SiDaMan1/Greenpower-Telemetry-REPO/esc controller/pcb/drc_report.txt

** Drc report for esc-controller.kicad_pcb **
** Created on 2026-09-05 22:09:33 **

** Found 0 DRC violations **

** Found 0 unconnected pads **

** Found 0 Footprint errors **

** End of Report **
