SiDaMan1/Greenpower-Telemetry-REPO/SESSION_NOTES.md

# SESSION_NOTES.md

**This file summarizes the most recent Claude Code session on this repo** — what got done, why, and anything still open. It's a companion to the `CLAUDE.md` files, not a replacement: `CLAUDE.md` files hold durable, load-bearing facts about the code; this file holds the narrative — what was discussed, decided, and why, that might not otherwise survive into a fresh session. It is **overwritten by each session**, not appended to — read it once at the start of a new session, then let it get replaced when that session wraps up.

---

## Session: 2026-08-20 (mobile PWA overhaul, agent tray icon, repo hand-off setup)

### What this session did, roughly in order

1. **Mobile UI added to `telemetry_web`** — the dashboard was desktop-only before this; added a real mobile layout (same `index.html`, CSS-gated) with PWA installability (manifest, service worker, icons).
2. **Several iterations on the mobile nav**, ending at: a fixed (non-scrollable) bottom bar showing 5 primary tabs (Overview/Speed/Power/RPM/ESC) as icon-only square buttons, plus an "expand" button that opens a small sheet listing all 12 tabs with icon+label. The expand button morphs its icon (hamburger↔X) rather than just rotating it — a plain rotation of a symmetric hamburger icon reads as "no animation happened."
3. **Overview page on mobile**: numbers-only (graphs hidden), stat cards are perfect squares in a 2-column grid with equal gaps on every side.
4. **Icon system**: replaced all emoji UI icons (nav, buttons, header) with a hand-authored inline-SVG set (`ICONS` map in `index.html`, applied via `applyIcons()`). Also replaced the placeholder lightning-bolt SVG app icon with the real Greenpower badge logo (PNG, generated at multiple sizes: favicon, apple-touch-icon, PWA icons incl. maskable) — used for the browser tab, home-screen icon, and the install prompt's own icon.
5. **Install prompt** is a small floating button + popover, not a banner — mobile-only (explicitly hidden on desktop via `@media (min-width:861px)` after it showed up there once).
6. **Raceline tab** now shows a real satellite map (Leaflet + Esri World Imagery tiles) with the GPS trail drawn on top, replacing a from-scratch canvas drawing that had no actual imagery.
7. **Chart stability fixes**: charts used to visibly lurch as the first few real data points arrived (auto-fitting axes to almost nothing). Now pre-filled with `MAX_POINTS` null placeholders + per-metric y-axis `suggestedMin/Max` seeded from `METRICS[k].range`. Chart tooltips now work on both hover (desktop) and tap (mobile) — they silently never worked before (`intersect:true` default against 0-radius points, which could never be hit).
8. **Real bugs found and fixed** (not design choices): IMU page's two chart-row sections overlapped on mobile (a `flex:1;min-height:0` sizing bug — the only page with two such stacked sections, so it was the only page where it showed); "LIVE" rendered twice in the header (duplicate write to `age-badge`); the mobile nav "expand" sheet was fully non-functional despite passing every event-wiring check (`.show` never set `display:`, only opacity/transform — classList/click-based testing can't catch a `display:none` bug since programmatic `.click()` doesn't require visibility); the bottom nav's active-tab highlight was a 44×42px box instead of a perfect square (hardcoded `width:44px` didn't match the margin-derived height) — switched to `aspect-ratio:1/1`.
9. **`receiver_agent` got a system tray icon** (`systray` npm package — note: `node-systray`/`node-systray-v2` are NOT what's published to npm despite what a lot of docs/READMEs imply; the real package name is `systray`). Shows a Greenpower-icon in the Windows tray whenever the agent is running, with a right-click "Stop Agent" menu item. **Not yet exercised on a live restart** — the agent needs to be restarted (re-run `setup.bat`, or next login) to pick this up, since Node doesn't hot-reload.
10. **`receiver_agent/config.json`** (real API key + dashboard URL) is now committed to git, previously gitignored — **the user was explicitly warned this repo is public** and confirmed they wanted to proceed anyway. If that key is ever rotated, it needs updating in Railway *and* in this committed file.
11. **Root-level docs added**: `README.md` (human-facing, includes a one-click "Download Receiver Agent" zip button via download-directory.github.io) and `CLAUDE.md` (AI-facing project map, this file's sibling).

### Known open items / things to double check next session
- The tray icon has not been confirmed working on an actual restarted agent process — worth asking if it looks right after the user restarts it.
- The Android PWA installed-app status bar showing the wrong (blue, not matching background) color was diagnosed as Chrome caching the *old* manifest on an already-installed copy — the fix is uninstall+reinstall the PWA on the phone, not a code change. Worth confirming this actually resolved it after the user does that.
- A lot of this session's CSS-transition/animation work was verified *structurally* (computed styles, classes) rather than visually, because the browser-preview tool used for verification in this environment doesn't composite frames (and so can't animate) unless its pane is actively displayed — this is a tooling limitation, documented in `telemetry_web/CLAUDE.md`, not a real limitation of the shipped code. If an animation ever looks broken to a real user, don't assume the earlier verification was wrong just because it couldn't watch the animation play.

### Why this file exists
The user asked, after a long back-and-forth about remote sessions and cloud hand-off: "can anyone make a new claude code session and pick up directly where i left off with no difference." The honest answer was: the code + `CLAUDE.md` files transfer perfectly, but *this specific conversation's history* — the discussion, the reasoning, the "why" that never made it into a committed file — does not. This file is the mitigation: a per-session summary of exactly that, committed alongside the code.
