SiDaMan1/Greenpower-Telemetry-REPO/esc controller/Claude outputs/bot.png

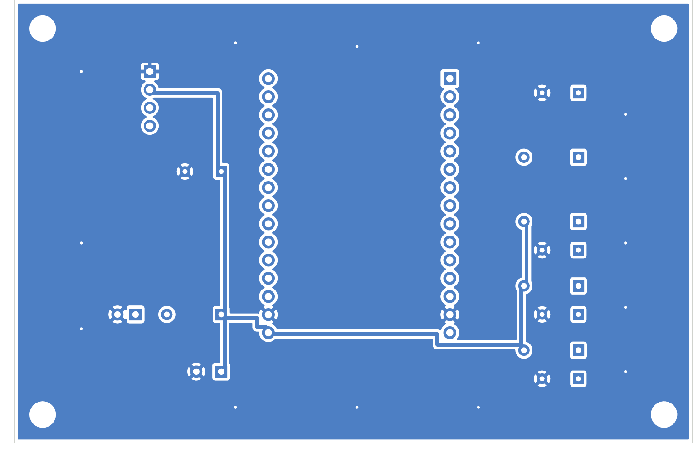
esc controller/Claude outputs/bot.png
