SiDaMan1/Greenpower-Telemetry-REPO/esc controller/Claude outputs/top.png

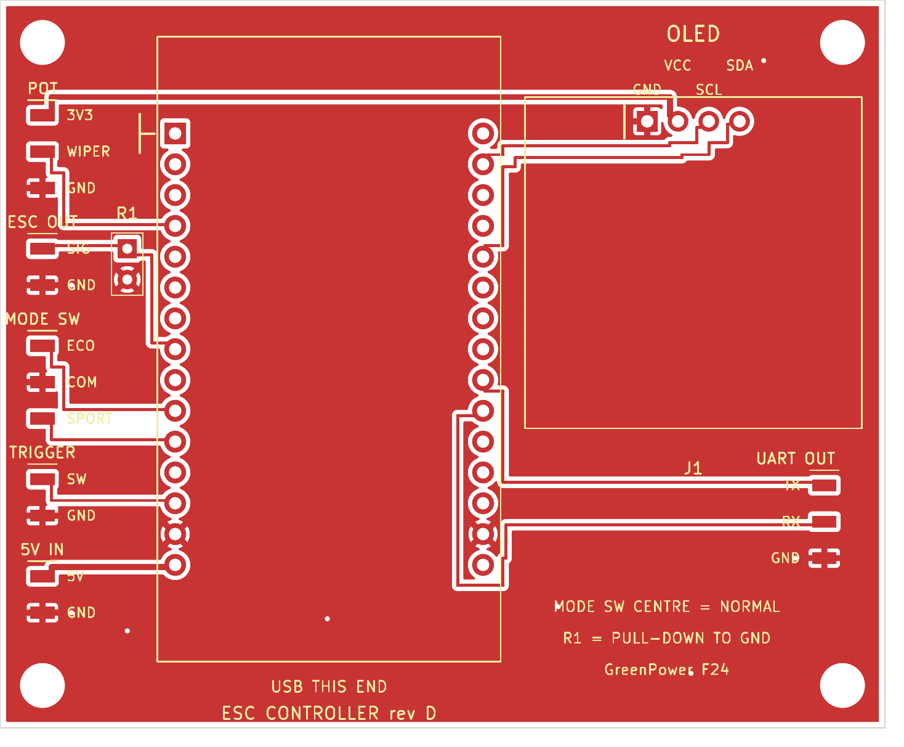
esc controller/Claude outputs/top.png
