SiDaMan1/Greenpower-Telemetry-REPO/esc controller/pcb/preview/bot.png

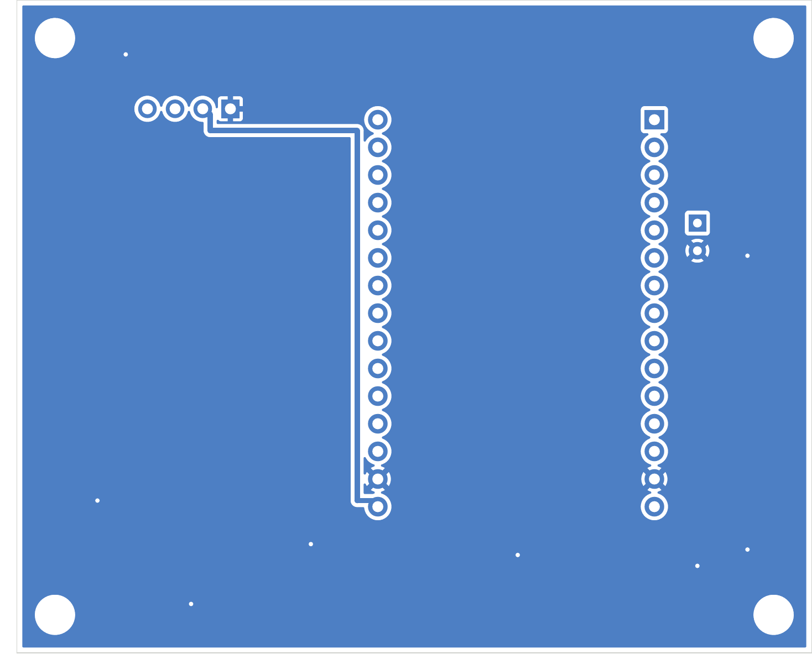
esc controller/pcb/preview/bot.png
