SiDaMan1/Greenpower-Telemetry-REPO/esc controller/pcb/preview/sch.png

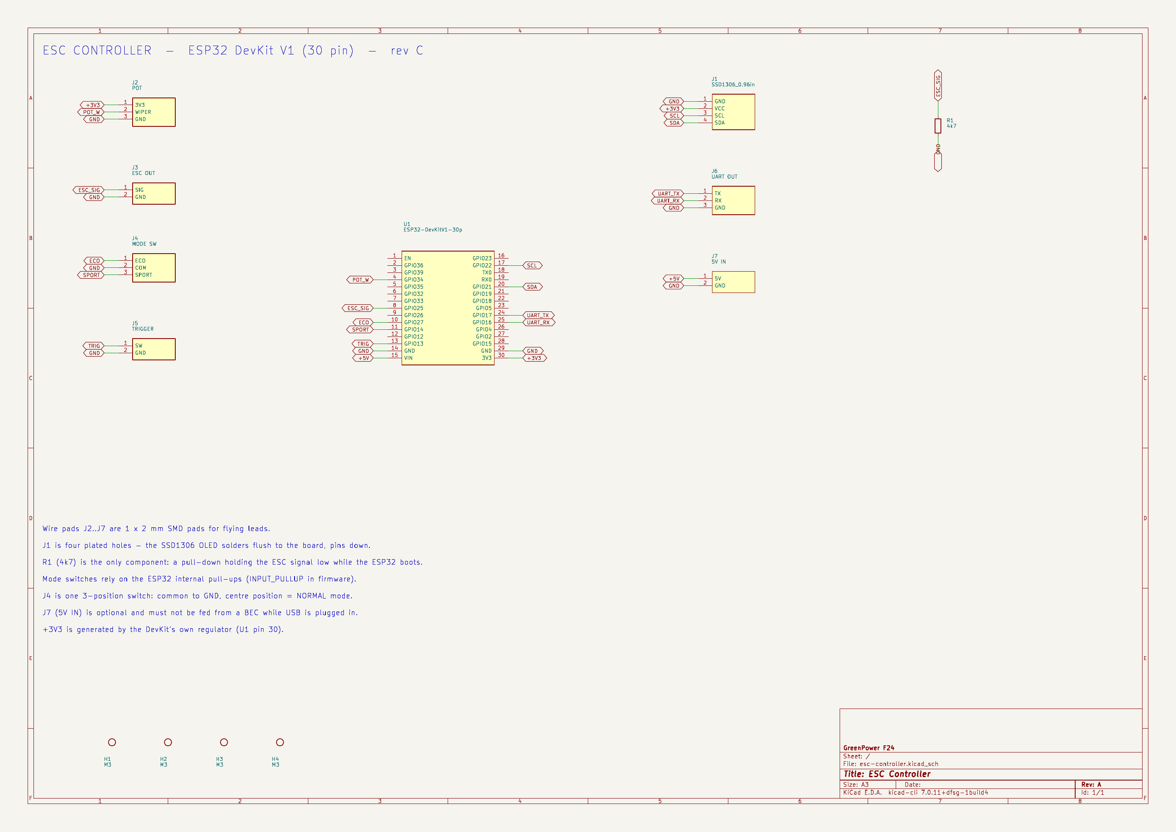
esc controller/pcb/preview/sch.png
