SiDaMan1/Greenpower-Telemetry-REPO/esc controller/pcb/esc-controller.kicad_pcb

## KiCad design esc controller/pcb/esc-controller.kicad_pcb (2026-09-10)

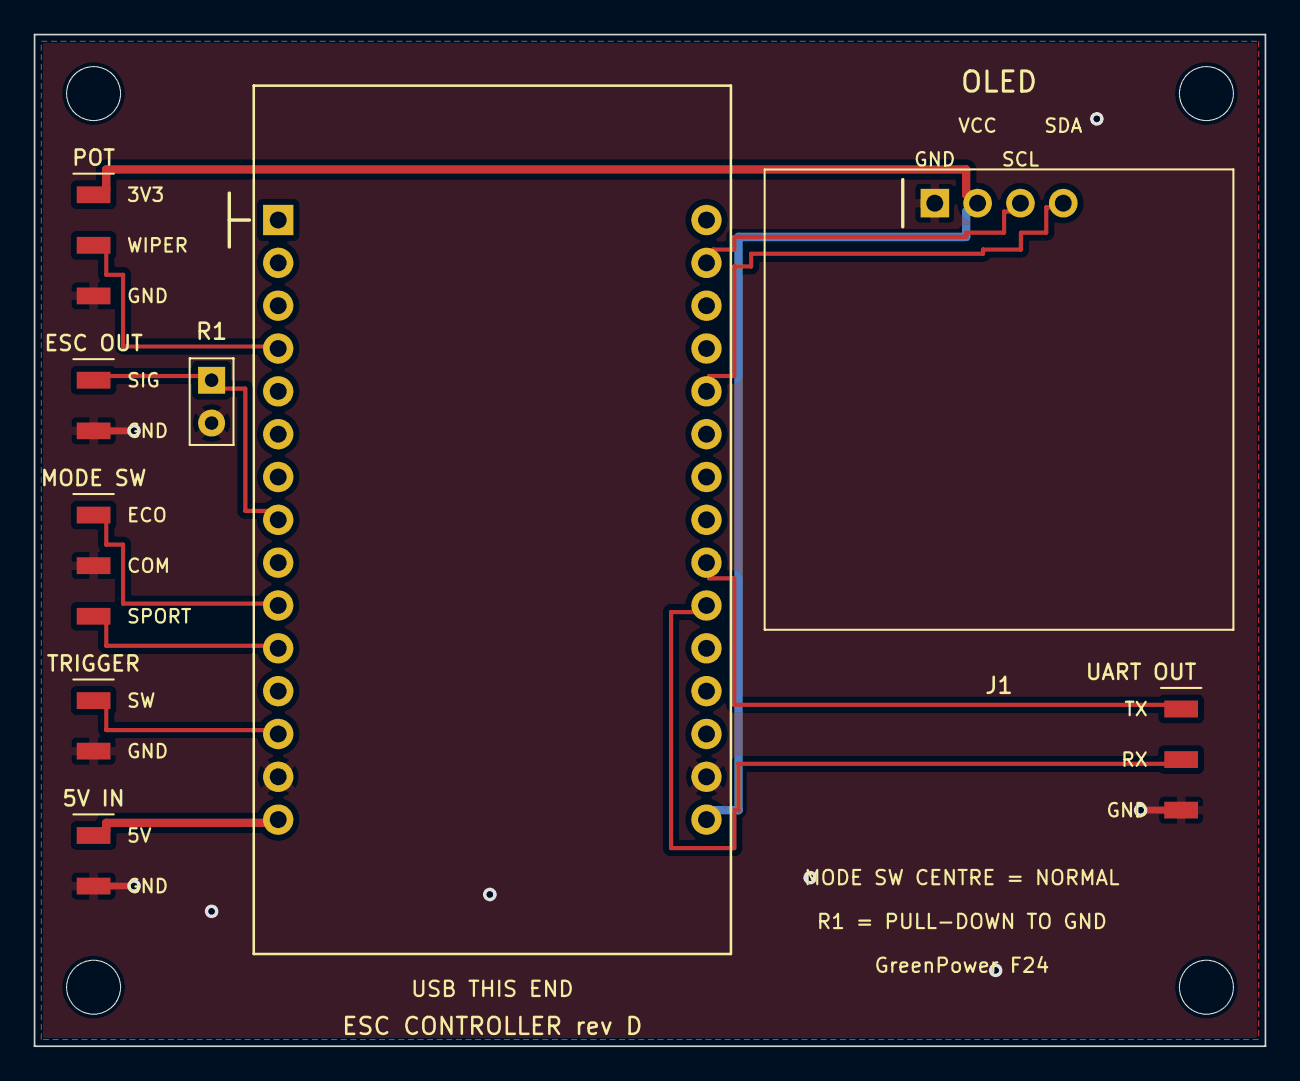
[picture p5: board esc-controller.kicad_pcb from above]

Board: 2 copper layers, 73.0 x 60.0 mm, 13 parts (0 on the bottom side), 12 nets.

Parts:
H1, H2, H3, H4: MountingHole_M3; MountingHole_3.2mm_M3
J1: SSD1306_0.96in; OLED_SSD1306_096_FLUSH_1x4
J2: WirePads; SOLDERPAD_POT_3P
J3: WirePads; SOLDERPAD_ESC_OUT_2P
J4: WirePads; SOLDERPAD_MODE_SW_3P
J5: WirePads; SOLDERPAD_TRIGGER_2P
J6: WirePads; SOLDERPAD_UART_OUT_3P
J7: WirePads; SOLDERPAD_5V_IN_2P
R1: 4k7; Resistor_THT_Axial_P2.54mm_Vertical
U1: ESP32-DevKitV1-30p; ESP32_DEVKITV1_30P_SOCKET

Connections:
+3V3: J1.2, J2.1, U1.30
+5V: J7.1, U1.15
ECO: J4.1, U1.10
ESC_SIG: J3.1, R1.1, U1.8
GND: J1.1, J2.3, J3.2, J4.2, J5.2, J6.3, J7.2, R1.2, U1.14, U1.29
POT_W: J2.2, U1.4
SCL: J1.3, U1.17
SDA: J1.4, U1.20
SPORT: J4.3, U1.11
TRIG: J5.1, U1.13
UART_RX: J6.2, U1.25
UART_TX: J6.1, U1.24
