SiDaMan1/Greenpower-Telemetry-REPO/Telemetry_pcb/Data collection pcb/Data collection pcb.kicad_pcb

## KiCad design Telemetry_pcb/Data collection pcb/Data collection pcb.kicad_pcb (2026-09-09)

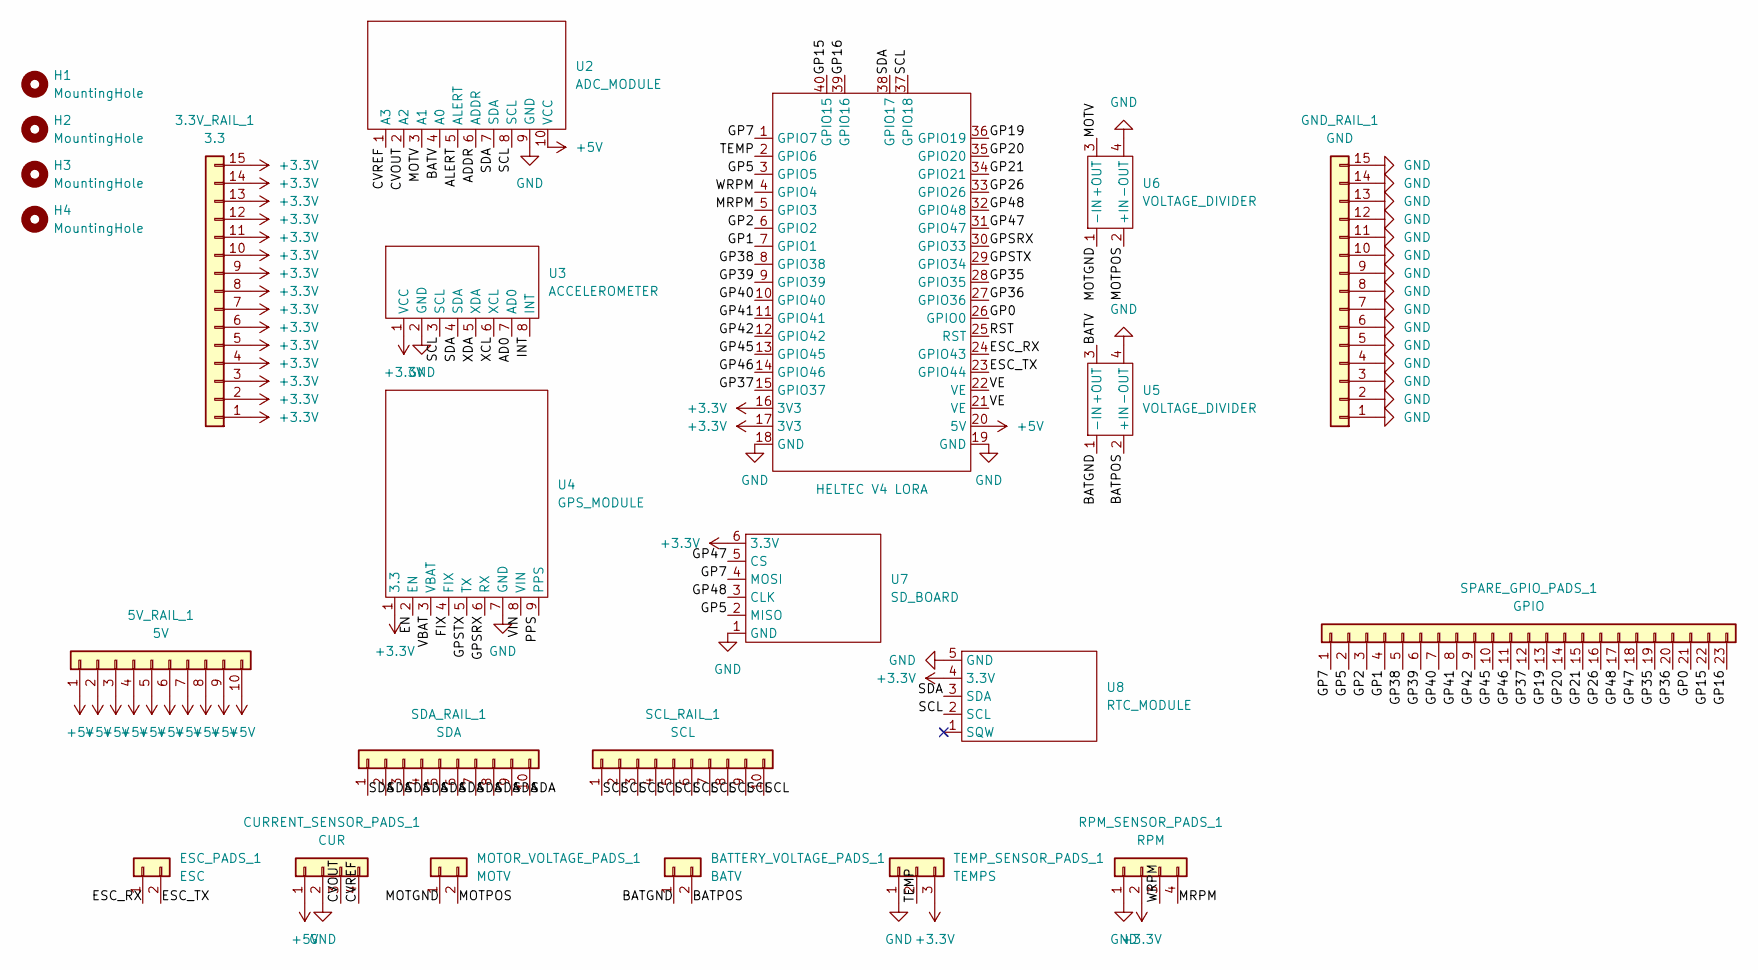
[picture p6: schematic Data collection pcb.kicad_sch]

Parts:
3.3V_RAIL_1: 3.3; 1X15 PADS
5V_RAIL_1: 5V; 1X10 PADS
BATTERY_VOLTAGE_PADS_1: BATV; 1X02 PADS
CURRENT_SENSOR_PADS_1: CUR; 1X04 PADS
ESC_PADS_1: ESC; 1X02 PADS
GND_RAIL_1: GND; 1X15 PADS
H1, H2, H3, H4: MountingHole; MountingHole_3.2mm_M3
MOTOR_VOLTAGE_PADS_1: MOTV; 1X02 PADS
RPM_SENSOR_PADS_1: RPM; 1X04 PADS
SCL_RAIL_1: SCL; 1X10 PADS
SDA_RAIL_1: SDA; 1X10 PADS
SPARE_GPIO_PADS_1: GPIO; 1X23 PADS
TEMP_SENSOR_PADS_1: TEMPS; 1X03 PADS
U1: HELTEC V4 LORA; HELTEC V4
U2: ADC_MODULE
U3: ACCELEROMETER
U4: GPS_MODULE
U5, U6: VOLTAGE_DIVIDER
U7: SD_BOARD
U8: RTC_MODULE

Connections:
+3.3V: 3.3V_RAIL_1.1, 3.3V_RAIL_1.2, 3.3V_RAIL_1.3, 3.3V_RAIL_1.4, 3.3V_RAIL_1.5, 3.3V_RAIL_1.6, 3.3V_RAIL_1.7, 3.3V_RAIL_1.8, 3.3V_RAIL_1.9, 3.3V_RAIL_1.10, 3.3V_RAIL_1.11, 3.3V_RAIL_1.12, 3.3V_RAIL_1.13, 3.3V_RAIL_1.14, 3.3V_RAIL_1.15, RPM_SENSOR_PADS_1.2, TEMP_SENSOR_PADS_1.3, U1.16 (3V3), U1.17 (3V3), U3.1 (VCC), U4.1 (3.3), U7.6 (3.3V), U8.4 (3.3V)
+5V: 5V_RAIL_1.1, 5V_RAIL_1.2, 5V_RAIL_1.3, 5V_RAIL_1.4, 5V_RAIL_1.5, 5V_RAIL_1.6, 5V_RAIL_1.7, 5V_RAIL_1.8, 5V_RAIL_1.9, 5V_RAIL_1.10, CURRENT_SENSOR_PADS_1.1, U1.20 (5V), U2.10 (VCC)
/AD0: U3.7 (AD0)
/ADDR: U2.6 (ADDR)
/ALERT: U2.5 (ALERT)
/BATGND: BATTERY_VOLTAGE_PADS_1.1, U5.1 (-IN)
/BATPOS: BATTERY_VOLTAGE_PADS_1.2, U5.2 (+IN)
/BATV: U2.4 (A0), U5.3 (+OUT)
/CVOUT: CURRENT_SENSOR_PADS_1.3, U2.2 (A2)
/CVREF: CURRENT_SENSOR_PADS_1.4, U2.1 (A3)
/EN: U4.2 (EN)
/ESC_RX: ESC_PADS_1.1, U1.24 (GPIO43)
/ESC_TX: ESC_PADS_1.2, U1.23 (GPIO44)
/FIX: U4.4 (FIX)
/GP0: SPARE_GPIO_PADS_1.21, U1.26 (GPIO0)
/GP1: SPARE_GPIO_PADS_1.4, U1.7 (GPIO1)
/GP2: SPARE_GPIO_PADS_1.3, U1.6 (GPIO2)
/GP5: SPARE_GPIO_PADS_1.2, U1.3 (GPIO5), U7.2 (MISO)
/GP7: SPARE_GPIO_PADS_1.1, U1.1 (GPIO7), U7.4 (MOSI)
/GP15: SPARE_GPIO_PADS_1.22, U1.40 (GPIO15)
/GP16: SPARE_GPIO_PADS_1.23, U1.39 (GPIO16)
/GP19: SPARE_GPIO_PADS_1.13, U1.36 (GPIO19)
/GP20: SPARE_GPIO_PADS_1.14, U1.35 (GPIO20)
/GP21: SPARE_GPIO_PADS_1.15, U1.34 (GPIO21)
/GP26: SPARE_GPIO_PADS_1.16, U1.33 (GPIO26)
/GP35: SPARE_GPIO_PADS_1.19, U1.28 (GPIO35)
/GP36: SPARE_GPIO_PADS_1.20, U1.27 (GPIO36)
/GP37: SPARE_GPIO_PADS_1.12, U1.15 (GPIO37)
/GP38: SPARE_GPIO_PADS_1.5, U1.8 (GPIO38)
/GP39: SPARE_GPIO_PADS_1.6, U1.9 (GPIO39)
/GP40: SPARE_GPIO_PADS_1.7, U1.10 (GPIO40)
/GP41: SPARE_GPIO_PADS_1.8, U1.11 (GPIO41)
/GP42: SPARE_GPIO_PADS_1.9, U1.12 (GPIO42)
/GP45: SPARE_GPIO_PADS_1.10, U1.13 (GPIO45)
/GP46: SPARE_GPIO_PADS_1.11, U1.14 (GPIO46)
/GP47: SPARE_GPIO_PADS_1.18, U1.31 (GPIO47), U7.5 (CS)
/GP48: SPARE_GPIO_PADS_1.17, U1.32 (GPIO48), U7.3 (CLK)
/GPSRX: U1.30 (GPIO33), U4.6 (RX)
/GPSTX: U1.29 (GPIO34), U4.5 (TX)
/INT: U3.8 (INT)
/MOTGND: MOTOR_VOLTAGE_PADS_1.1, U6.1 (-IN)
/MOTPOS: MOTOR_VOLTAGE_PADS_1.2, U6.2 (+IN)
/MOTV: U2.3 (A1), U6.3 (+OUT)
/MRPM: RPM_SENSOR_PADS_1.4, U1.5 (GPIO3)
/PPS: U4.9 (PPS)
/RST: U1.25 (RST)
/SCL: SCL_RAIL_1.1, SCL_RAIL_1.2, SCL_RAIL_1.3, SCL_RAIL_1.4, SCL_RAIL_1.5, SCL_RAIL_1.6, SCL_RAIL_1.7, SCL_RAIL_1.8, SCL_RAIL_1.9, SCL_RAIL_1.10, U1.37 (GPIO18), U2.8 (SCL), U3.3 (SCL), U8.2 (SCL)
/SDA: SDA_RAIL_1.1, SDA_RAIL_1.2, SDA_RAIL_1.3, SDA_RAIL_1.4, SDA_RAIL_1.5, SDA_RAIL_1.6, SDA_RAIL_1.7, SDA_RAIL_1.8, SDA_RAIL_1.9, SDA_RAIL_1.10, U1.38 (GPIO17), U2.7 (SDA), U3.4 (SDA), U8.3 (SDA)
/TEMP: TEMP_SENSOR_PADS_1.2, U1.2 (GPIO6)
/VBAT: U4.3 (VBAT)
/VE: U1.21 (VE), U1.22 (VE)
/VIN: U4.8 (VIN)
/WRPM: RPM_SENSOR_PADS_1.3, U1.4 (GPIO4)
/XCL: U3.6 (XCL)
/XDA: U3.5 (XDA)
GND: CURRENT_SENSOR_PADS_1.2, GND_RAIL_1.1, GND_RAIL_1.2, GND_RAIL_1.3, GND_RAIL_1.4, GND_RAIL_1.5, GND_RAIL_1.6, GND_RAIL_1.7, GND_RAIL_1.8, GND_RAIL_1.9, GND_RAIL_1.10, GND_RAIL_1.11, GND_RAIL_1.12, GND_RAIL_1.13, GND_RAIL_1.14, GND_RAIL_1.15, RPM_SENSOR_PADS_1.1, TEMP_SENSOR_PADS_1.1, U1.18 (GND), U1.19 (GND), U2.9 (GND), U3.2 (GND), U4.7 (GND), U5.4 (-OUT), U6.4 (-OUT), U7.1 (GND), U8.5 (GND)

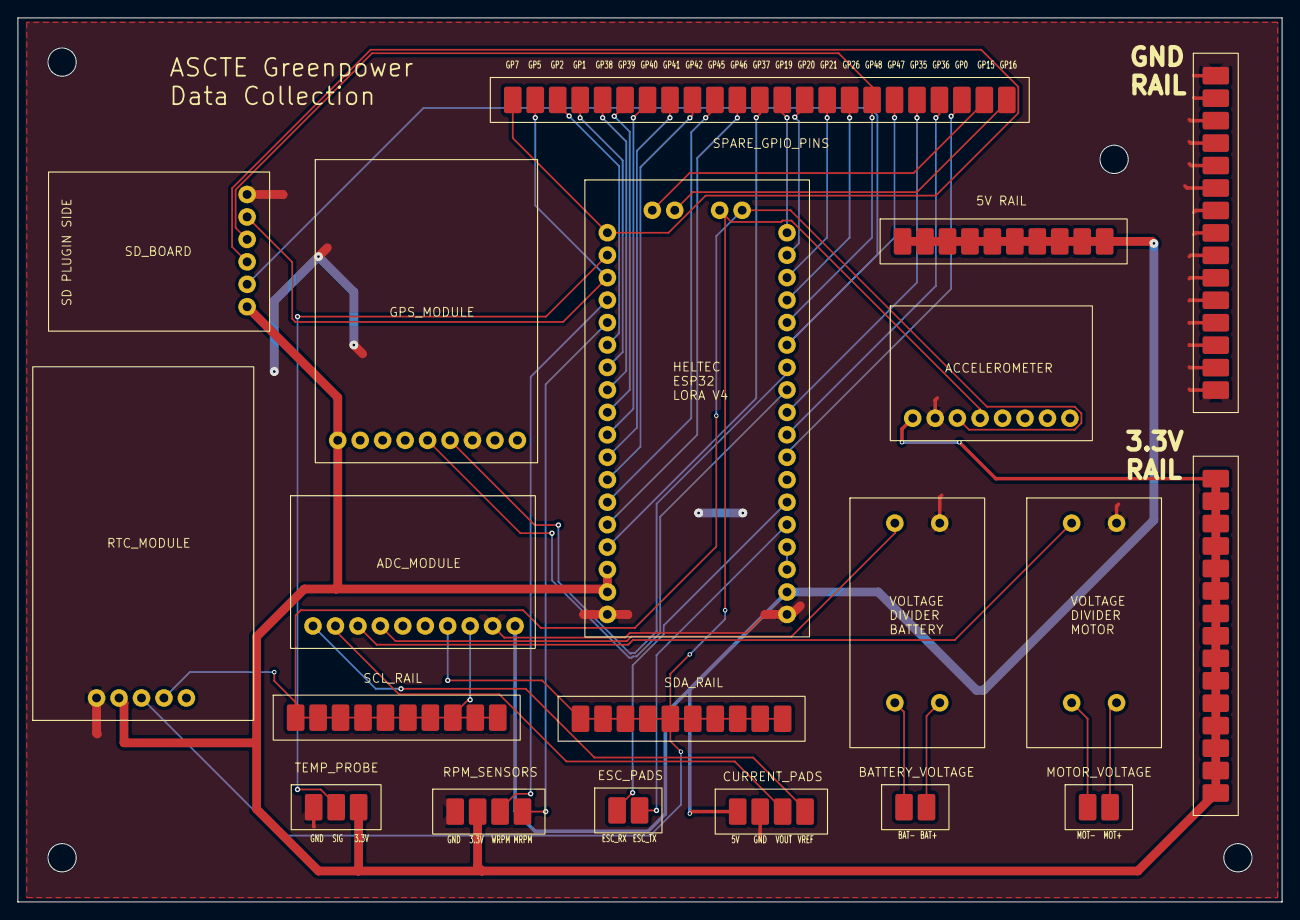
[picture p7: board Data collection pcb.kicad_pcb from above]

Board: 2 copper layers, 143.0 x 100.0 mm, 24 parts (0 on the bottom side), 44 nets.
