SiDaMan1/Greenpower-Telemetry-REPO/greenpower_sender/greenpower_sender.ino

// ════════════════════════════════════════════════════════════════════
//  GREENPOWER SENDER  —  V3  (breadboard, sensors + LoRa + ESP-NOW)
//  Heltec ESP32-S3 LoRa WiFi V4
//
//  Sensors collected (all point-to-point wiring, no PCB):
//    • GPS NMEA         — Adafruit Ultimate GPS Breakout V3, Serial1
//                          GPIO34 = ESP32 RX (from GPS TX)
//                          GPIO33 = ESP32 TX (to GPS RX)
//    • IMU              — HW-123 (MPU6050-compatible), I2C SDA=17/SCL=18
//    • Temp probe        — DS18B20, 1-Wire digital, GPIO6 (4.7k pull-up to VCC)
//    • ADS1115 (Lonely Binary board), I2C SDA=17/SCL=18, addr 0x48:
//         A0 = motorVolt   — via 5:1 divider (VCC<25V)
//         A1 = battVolt    — via 5:1 divider (VCC<25V)
//         A2 = Vout        — YHDC HSTS016L 100A current sensor output
//         A3 = Vref        — YHDC HSTS016L reference (measured, not assumed)
//    • Motor RPM         — laser-interrupt disc sensor, GPIO4 (CHANGE-edge, polarity-agnostic)
//    • Wheel RPM         — laser-interrupt disc sensor, GPIO3 (CHANGE-edge, polarity-agnostic)
//    • ESC controller    — UART (Serial2), GPIO44(RX)/GPIO43(TX), from
//                          ../esc controller/throttle_controller.ino (ESP32
//                          WROOM-32, TX=GPIO17/RX=GPIO16 on that end).
//                          20 Hz CSV: mode,state,setpointPct,livePct,rampPct
//    • SD card           — local telemetry backup, own SPI bus (separate
//                          from the LoRa radio's), CS=47 SCK=48 MOSI=7
//                          MISO=5. Logs every packet to /LOGnnn.CSV
//                          regardless of whether the LoRa link is up.
//    • RTC               — Elegoo DS1307-V03, own I2C bus (Wire1) on
//                          GPIO1(SDA)/GPIO2(SCL) — NOT the shared IMU/ADS1115
//                          bus (GPIO17/18), because the DS1307 is fixed at
//                          I2C address 0x68, same as the MPU6050-compatible
//                          IMU already on that bus. Stamps each SD log row
//                          with real wall-clock time instead of just millis().
//
//  LoRa TX: SX1262  NSS=8 RST=12 DIO1=14 BUSY=13  SPI SCK=9 MISO=11 MOSI=10
//           Transmits telemetry_packet_t (now includes ESC fields) every
//           ~218ms (SF9/BW125, implicit header, 6-symbol preamble, 33-byte
//           fixed-point-compressed packet — latency prioritized over range
//           per direct request; see LORA_SCK's own comment for the full
//           history)
//
//  ESP-NOW TX: to the steering wheel display_receiver, same CSV format as
//              mock_sender — see espNowSend() below. Mode/state/percent
//              fields now come from the real ESC link; fall back to "---"/0
//              placeholders only if no ESC line has ever been parsed.
//
//  NOTE: ADS1115 must be powered from 5V, not 3.3V — the voltage-divider
//  channels can swing up to ~5V (25V input / 5:1) and would clip against
//  a 3.3V supply rail regardless of gain setting.
//
//  Required libraries (install via Arduino Library Manager):
//    • TinyGPS++               (Mikal Hart)
//    • Adafruit MPU6050        (Adafruit)
//    • Adafruit Unified Sensor (Adafruit)
//    • Adafruit ADS1X15        (Adafruit)
//    • OneWire                 (Paul Stoffregen)
//    • DallasTemperature       (Miles Burton)
//    • RadioLib                (jgromes)
//    • SD                      (built into the ESP32 Arduino core — no
//                                separate Library Manager install needed)
//    • RTClib                  (Adafruit) — DS1307 driver
// ════════════════════════════════════════════════════════════════════

#include <Arduino.h>
#include <SPI.h>
#include <Wire.h>
#include <WiFi.h>
#include <esp_now.h>
#include <math.h>
#include <TinyGPSPlus.h>
#include <Adafruit_MPU6050.h>
#include <Adafruit_Sensor.h>
#include <Adafruit_ADS1X15.h>
#include <OneWire.h>
#include <DallasTemperature.h>
#include <RadioLib.h>
#include <string.h>
#include <stdlib.h>
#include <SD.h>
#include <RTClib.h>
#include "config.h"


// ════════════════════════════════════════════════════════════════════
//  PIN ASSIGNMENTS
// ════════════════════════════════════════════════════════════════════

#define VEXT_CTRL         36   // External sensor power rail (active LOW) — Heltec V4

// LoRa SPI pins (fixed on Heltec V4). NSS/RST/DIO1/BUSY are in config.h
// since a receiver on the same board type would share them.
#define LORA_SCK           9
#define LORA_MISO         11
#define LORA_MOSI         10
// ⚠️ FOURTH pass: latency now prioritized over range, explicitly, per a
// direct request to get latency "as close to zero as possible even if
// that means shorter range." The SF12+BW62.5 range attempt above is
// reverted — that config's ~6.9s airtime was itself the dominant source
// of the "takes way too long to reach the receiver" complaint. Levers
// pulled, safest first:
//   1. Coding rate was already 4/5 (the fastest available) — no change.
//   2. Spreading factor back to SF7 — the lowest value already PROVEN
//      safe on this exact hardware at the time. (SF10/SF12 appeared to
//      hang the receiver's radio.begin() in earlier testing — since
//      corrected by the user: that was caused by an incorrect flashing
//      procedure, NOT a real SF incompatibility, so SF8+ is not actually
//      known-risky territory — see CLAUDE.md's ✅ CORRECTION note. Kept at
//      SF7 in THIS pass because the goal here was latency, not range.)
//   3. Bandwidth raised from 125 to 500 kHz — the actual range-for-
//      latency trade that was explicitly authorized ("even if that means
//      shorter range... do this last"). Higher bandwidth = shorter
//      symbol duration = far less airtime, at the direct cost of
//      receiver sensitivity/range (roughly -12dB of link budget vs
//      125kHz — a real, substantial range reduction, not a minor one).
//
// ⚠️ FIFTH pass: bandwidth brought back DOWN to 125 kHz, per a direct
// follow-up request — "increase range without increasing airtime and how
// often it sends packets... I want it to update every 200ms still." The
// key realization: this project's own compression work (packet size,
// implicit header, trimmed preamble — steps 1-3 below) had, by this
// point, shrunk SF7/BW500's airtime down to ~21ms — using barely 10% of
// the 200ms update budget. There was ~180ms of slack sitting completely
// unused. BW125 costs real airtime (narrower bandwidth = longer symbol
// duration = more time per bit) but buys real range/sensitivity back —
// and at this packet's current (compressed) size, BW125 only costs
// ~85ms, still comfortably under 200ms with ~115ms of margin to spare.
// SF stays at 7 in THIS pass simply because it's already proven safe and
// range wasn't blocked on it — NOT because SF9+ is risky; the earlier
// "SF10/SF12 hangs this board" finding was later corrected by the user
// (a flashing mistake at the time, not a real incompatibility — see
// CLAUDE.md's ✅ CORRECTION note), so a higher SF is a legitimate option
// to reconsider later if BW125 alone isn't enough range.
// BW125 is literally this project's ORIGINAL setting, from before the
// whole latency-optimization thread (steps 1-3 immediately above) ever
// started, just now running on top of a much smaller packet than it used
// to. See this folder's CLAUDE.md for the full reasoning and the airtime
// budget table considered (SF7/BW250 and SF9/BW250 were also on the
// table; BW125 was picked as the best proven-safe/gain tradeoff).
//
// Time-on-air at SF7/BW125 for this 44-byte packet (implicit header,
// 6-symbol preamble), same Semtech formula used throughout this
// project's LoRa history: symbol duration = 2^7/125000 = 1.024ms.
// Preamble ≈ (6+4.25)×1.024ms ≈ 10.5ms. Payload ≈ 73 symbols ×
// 1.024ms ≈ 74.8ms. Total ≈ 85ms per transmission — a real range/
// sensitivity gain over BW500's ~21ms.
//
// ⚠️ SIXTH pass: pushed further, per a direct follow-up — "extend the
// range as much as possible up to 200ms with a little headroom... max
// range without sacrificing an update every 200ms." BW125 above only
// spent ~85ms of the 200ms budget; there was still ~115ms of slack left
// on the table. Bandwidth dropped again, to 62.5 kHz — SF stays at 7
// (still no reason to touch it; see the ✅ CORRECTION note in CLAUDE.md —
// SF9+ is a legitimate option too, but a bandwidth-only step was simpler
// to reason about and reuses a combination this project already ran
// once before, at SF12/BW62.5, without incident).
// This specific SF7/BW62.5 time-on-air was computed the same way every
// prior pass in this file has been (see CLAUDE.md for the full numbers)
// — total ≈ 160ms per transmission at that point (44-byte packet), still
// comfortably under the 200ms update interval. This is close to the
// practical ceiling for what's achievable purely via bandwidth at SF7
// within a 200ms budget on this packet — going any lower (BW41.7 and
// below) would exceed 200ms outright even at a much smaller packet size
// (checked down to ~34 bytes — still over), and the next real range
// lever past this point is a higher spreading factor instead, not a
// lower bandwidth.
// LORA_TX_INTERVAL_MS is, again, completely unchanged — "how often it
// sends" was never touched by any bandwidth pass, only how long each
// individual transmission takes.
//
// ⚠️ SEVENTH pass: airtime_ms_x10 (the real measured-airtime field added
// two passes ago) removed entirely, per explicit request ("get rid of
// the airtime measurement completely i dont want it anymore") — packet
// back down to 42 bytes. The micros()-based ISR timing in
// checkLoraTxComplete()/loRaTx() (loraTxDoneUs/loraTxStartUs) was removed
// along with it — nothing in this file measures real airtime anymore,
// only the Semtech-formula estimates in comments like this one.
//
// ⚠️ EIGHTH pass: further packet optimization, per explicit follow-up
// ("is there any way you can extend range more or optimise the packets
// sent") — three changes, all chosen to cost real precision only where
// it plainly doesn't matter:
//   1. esc_mode_code folded into flags bits 4-5 (pktGetEscMode()/
//      pktSetEscMode() in config.h) instead of its own byte — an exact
//      2-bit fit for its 4 possible values (ECO/NORMAL/SPORT/UNKNOWN),
//      genuinely zero precision loss. esc_state_code was deliberately
//      NOT packed alongside it — it has 5 possible values (needs 3 bits),
//      and mode(2)+state(3) doesn't fit flags' 4 spare bits without
//      actually losing the "unrecognized ESC state string" case — see
//      config.h's own comment for the full reasoning on why that one
//      byte was left alone rather than force a real (if tiny) loss.
//   2. temp_f_x10 (int16, 0.1°F res) → temp_f (int8, whole °F) — saves
//      1 byte, trades a decimal place nobody reads on a temperature
//      readout for it.
//   3. pitch_deg_x100 (int16, 0.01° res) → pitch_deg (int8, whole °) —
//      same trade, pitch is a coarse tilt indicator, not a precision
//      instrument.
// Packet 42 → 39 bytes. New time-on-air ≈ 150ms at SF7/BW62.5 — checked
// against every SF/BW combo under the 200ms budget at this new smaller
// size and confirmed SF7/BW62.5 is STILL the best available option (a
// smaller packet buys back margin, not a better bandwidth tier — BW41.7
// still needs roughly a 25-byte packet to fit under 200ms, well past
// what these three trims alone reach) — see this folder's CLAUDE.md for
// the full comparison table. Going further (dropping epoch_time,
// relative-offset GPS instead of full lat/lon) was discussed and
// declined at the time — real feature loss for only ~1.8dB more
// sensitivity. (Update, NINTH pass below: epoch_time WAS later dropped,
// on its own explicit merits — not for the sensitivity gain, which
// still didn't materialize — see below.)
//
// ⚠️ NINTH pass: epoch_time removed entirely, per explicit request ("I
// don't need to send RTC. Instead only log that on the sd card and
// retrieve the time from the internet and log that into the server
// sessions.") — see epoch_time's own removal comment in config.h and
// near its old assignment site below for the full reasoning (short
// version: the dashboard's server was already using its own real-time
// clock for every stored timestamp, never this field, so nothing
// downstream actually lost anything). Packet 39 → 35 bytes, ≈140ms.
// Checked again whether this unlocks more range — it doesn't; SF7/BW62.5
// is still the best option under the 200ms budget even at 35 bytes.
//
// ⚠️ TENTH pass: further LOSSLESS compression, per explicit follow-up
// ("compress it more... without losing data") — satellites and
// esc_state packed into ONE byte instead of two (pktGetSatellites()/
// pktSetSatellites()/pktGetEscState()/pktSetEscState() in config.h; see
// that file's own comment for the exact bit layout and the one
// deliberate assumption behind it — satellite count never exceeding 31,
// safely generous for this GPS module). Packet 35 → 34 bytes. This one
// byte alone does NOT reduce airtime (the Semtech formula's payload-
// symbol count doesn't actually drop until 32 bytes — checked directly,
// 35/34/33 bytes all compute to the identical 58 symbols/~140ms; only at
// 32 bytes does it drop to 53 symbols/~130ms) — done anyway since it was
// explicitly asked for and costs nothing, but flagged honestly rather
// than implied as a real airtime win it isn't (yet).
//
// ⚠️ ELEVENTH pass: batt_volt/motor_volt/current_a cross-byte packed into
// 5 bytes (pktEncVolt12()/pktEncCurrent14()/pktPackVoltCur() in config.h),
// using real confirmed vehicle bounds (voltage ≤30V, current ≤120A,
// always positive — no regen braking, a real correction to this struct's
// earlier signed-current assumption). Packet 34 → 33 bytes — still the
// identical ~140ms, one byte short of the real 32-byte threshold. Chasing
// that last byte further (motor_rpm/wheel_rpm bit-packing) was raised and
// dropped — only motor RPM's real bound was confirmed, not wheel RPM's,
// and packing just one of a pair buys nothing (12+16 bits still needs 4
// bytes, same as today) — see this folder's CLAUDE.md for the full
// reasoning; not guessed at without both real numbers.
//
// ⚠️ TWELFTH pass: cadence relaxed 200ms → 250ms, explicitly, specifically
// to buy real headroom for a range increase ("instead of sending data
// every 1/5s do 1/4s... that way there is more headroom. max out the
// range as much as possible within 250ms"). SENSOR_INTERVAL_MS/
// RPM_CALC_INTERVAL_MS/LORA_TX_INTERVAL_MS/ESPNOW_TX_INTERVAL_MS all moved
// together — this changes the sensor sample rate too, not just the radio
// send rate (5Hz → 4Hz update rate on the dashboard, an explicit,
// accepted tradeoff for the range gain, not a side effect). SF/BW moved
// to SF9/BW125 — checked every combo under the new 250ms budget; the
// theoretical best (SF8/BW62.5, -128.5dBm) only had ~11ms margin, too
// tight for what this whole pass was FOR (real headroom, per the user's
// own stated reason for the interval change) — SF9/BW125 gives -128dBm
// (0.5dB less, functionally the same real-world range) with ~32ms of
// actual margin instead. See this folder's CLAUDE.md for the full
// candidate table. SF9 has no more hang risk than any other spreading
// factor on this board — the earlier SF10/SF12 "hangs" were confirmed to
// be a flashing mistake, not a real incompatibility (see the ✅
// CORRECTION note above) — this is a genuinely new SF for this project,
// just not a newly-risky one.
#define LORA_TX_INTERVAL_MS    250   // ~218ms SF9/BW125 airtime (33-byte packet, implicit hdr, 6-symbol preamble) + ~32ms real margin — matches sensor/ESP-NOW cadence
#define ESPNOW_TX_INTERVAL_MS  250   // unchanged relative to LORA_TX_INTERVAL_MS — 4 Hz, matches SENSOR_INTERVAL_MS

#define GPS_RX_PIN        34   // ESP32 RX  ← GPS TX
#define GPS_TX_PIN        33   // ESP32 TX  → GPS RX
#define GPS_BAUD        9600   // Adafruit Ultimate GPS Breakout V3 default

#define I2C_SDA_PIN       17   // shared I2C bus: IMU + ADS1115
#define I2C_SCL_PIN       18

#define TEMP_PROBE_PIN     6   // DS18B20 1-Wire data (needs 4.7k pull-up to VCC)

#define ESC_RX_PIN        44   // ESP32 RX  ← ESC controller TX (GPIO17 on that board)
#define ESC_TX_PIN        43   // ESP32 TX  → ESC controller RX (GPIO16 on that board) — unused by the ESC's code today, wired for symmetry
#define ESC_BAUD      115200   // must match throttle_controller.ino's Serial1.begin()

#define MOTOR_RPM_PIN      4   // laser-interrupt — motor disc (was wrongly 48 — never wired)
#define WHEEL_RPM_PIN      3   // laser-interrupt — wheel disc (was wrongly 47 — never wired)
                                // GPIO3 is a boot-strapping pin — fine as a normal input
                                // after boot, don't be alarmed by a reading that looks odd
                                // for an instant right at power-up.

// ── RPM disc slots per revolution ────────────────────────────────────
// Count the slots on each disc and update these values.
#define MOTOR_SLOTS_PER_REV  1
#define WHEEL_SLOTS_PER_REV  1

// These are unbranded modules with no datasheet, so idle/triggered polarity
// isn't assumed — see the RPM section below for how that's handled.
// If a sensor's output is open-collector rather than push-pull, it needs an
// external or internal pull resistor to idle at a defined level; try
// INPUT_PULLUP first (idle HIGH, most common for these break-beam modules).
#define RPM_PIN_MODE      INPUT_PULLUP

// ── SD card (local telemetry log) ────────────────────────────────────
// A SEPARATE SPI bus from the on-board LoRa radio's — the radio's SPI
// (SCK=9/MISO=11/MOSI=10, see config.h) is wired chip-to-chip internally
// to the co-packaged SX1262 and was never broken out to a header pin at
// all, so there's nothing to physically share. These four pins were
// specifically cross-checked against every other pin already in use on
// this board (GPS/I2C/temp/ESC/RPM above, plus the LoRa radio's own
// internal pins) before being chosen — see greenpower_sender/CLAUDE.md's
// SD-card rule for the full pin-conflict check. GPIO47/48 have no other
// function on this board at all; GPIO5/7 are touch/ADC1-capable but that
// doesn't stop them being used as plain digital SPI pins here.
#define SD_CS_PIN         47
#define SD_SCK_PIN        48
#define SD_MOSI_PIN        7
#define SD_MISO_PIN        5

// ── RTC (Elegoo DS1307-V03) ──────────────────────────────────────────
// A SECOND, independent I2C bus — NOT the existing GPIO17/18 bus. The
// DS1307 has a fixed, non-configurable I2C address (0x68), which is the
// exact same address the MPU6050-compatible IMU already answers to on
// that bus — putting both on one bus means one of them silently doesn't
// respond. The ESP32-S3's I2C peripheral goes through the chip's internal
// GPIO matrix (unlike, say, the LoRa radio's SPI pins, which are hardwired
// chip-to-chip) so a second bus can live on any free GPIO pair — GPIO1/2
// were cross-checked against every other pin already in use on this board
// (see SD_*_PIN's own comment above and greenpower_sender/CLAUDE.md) and
// are clean. Uses the ESP32's second hardware I2C controller (TwoWire
// instance #1) via rtcWire below — this is a genuinely separate bus, not
// a software/bit-banged one.
#define RTC_SDA_PIN        1
#define RTC_SCL_PIN        2   // ⚠️ RTC currently DISABLED (initRtc() not called) — this pin is reused below as FEM_EN_PIN. See both comments before reusing this bus.

// ⚠️ Heltec V4 antenna front-end enable — real bug found and fixed this
// pass, reported as "-120dBm at only 15ft, is this normal?" (no). This
// board routes its LoRa antenna through an external front-end module
// (a GC1109 power-amp/LNA chip) sitting BETWEEN the SX1262 and the
// antenna connector — separate hardware from the SX1262 itself, so
// RadioLib (which only knows about the SX1262 chip) has no way to
// control it. Without these two pins driven correctly, the FEM stays
// powered down and the antenna path is effectively dead — packets barely
// leak through and RSSI sits pinned near the noise floor, exactly
// matching the reported symptom. Confirmed against TWO independent
// sources (not just one forum post): a Reddit report of the identical
// fix, and a real GitHub PR to the MeshCore project (which specifically
// maintains Heltec-V4 hardware support) using the exact same two pins.
//   FEM_EN_PIN  (a.k.a. CSD, "chip shutdown", active HIGH = enabled) —
//     powers up the FEM itself; needed for BOTH transmit AND receive,
//     since the whole antenna path (TX power-amp AND RX low-noise-amp)
//     routes through this one chip. This is THE fix for the reported
//     RSSI-near-noise-floor symptom.
//   FEM_CPS_PIN (a.k.a. CPS, "current path select") — selects full-power
//     PA mode for transmit vs. a lower-power bypass path. Matters most
//     for TX; harmless to also assert on a receive-only board.
// FEM_CPS_PIN (46) is one of the ESP32-S3's four hardware STRAPPING pins
// (sampled at boot to select flash/console behavior) — but that sampling
// only happens during the very early boot ROM, before this sketch's
// setup() ever runs, so driving it as a normal output afterward is safe
// UNLESS this sketch ever starts using esp_deep_sleep() (which re-runs
// the same boot-time strapping sample on wake) — it doesn't today, this
// being an always-on vehicle telemetry unit, not a sleep-cycling one.
// Revisit this pin's handling if deep sleep is ever added later.
#define FEM_EN_PIN         2   // CSD — same physical pin RTC_SCL_PIN used before the RTC was disabled above
#define FEM_CPS_PIN       46   // CPS — strapping pin, see comment above

// ADS1115 (Lonely Binary board) — I2C address, ADDR pin → GND = 0x48
#define ADS_I2C_ADDR      0x48
#define ADS_MOTOR_V_CH       0   // A0
#define ADS_BATT_V_CH        1   // A1
// A2/A3 read together as a differential pair for the current sensor (see below)


// ════════════════════════════════════════════════════════════════════
//  CALIBRATION CONSTANTS
// ════════════════════════════════════════════════════════════════════

// Voltage dividers — nominally 5:1, rated for VCC < 25 V (divided output maxes ~5 V).
// Two physically separate resistor pairs — even nominally identical resistors
// have tolerance, so each divider gets its own calibrated ratio rather than
// sharing one constant. Calibration procedure is in CLAUDE.md.
static const float VDIV_RATIO_MOTOR = 0.19893f;   // calibrated: sketch=12.97V, multimeter=13.04V
static const float VDIV_RATIO_BATT  = 0.19954f;   // calibrated: sketch=13.02V, multimeter=13.05V

// YHDC HSTS016L 100 A current sensor, read differentially (Vout - Vref)
// on ADS1115 A2/A3, so no zero-offset constant is needed — Vref is
// measured directly every sample instead of assumed.
//   Amps = (Vout - Vref) / CURRENT_SENS
// CURRENT_SENS (V per A) depends on sensor supply voltage — calibrate
// against a known load.
static const float CURRENT_SENS = 0.016f;   // V per A — placeholder, calibrate

// DS18B20 needs no calibration constants — it's a digital sensor with its
// own factory-calibrated ADC, unlike the analog dividers above.


// ════════════════════════════════════════════════════════════════════
//  PERIPHERAL OBJECTS
// ════════════════════════════════════════════════════════════════════

TinyGPSPlus       gps;
Adafruit_MPU6050  mpu;
Adafruit_ADS1115  ads;
OneWire           oneWire(TEMP_PROBE_PIN);
DallasTemperature tempSensor(&oneWire);

// A dedicated second SPI bus (HSPI) for the SD card — the default `SPI`
// object/pins are already claimed by the LoRa radio (SPI.begin() with
// LORA_SCK/MISO/MOSI in setup() below).
//
// ⚠️ REAL, CONFIRMED bug this replaced: this was originally `SPIClass
// sdSPI(FSPI)`, on the (wrong) assumption that requesting a SEPARATE
// SPIClass object on different pins automatically means separate
// hardware. It does NOT: on the ESP32-S3, arduino-esp32's own default
// global `SPI` object (the one LoRa's `SPI.begin(LORA_SCK, ...)` call
// uses) is ITSELF instantiated as `SPIClass SPI(FSPI)` internally — so a
// second `SPIClass sdSPI(FSPI)` here wraps the EXACT SAME underlying
// SPI2_HOST peripheral, not an independent one, regardless of which GPIO
// pins either .begin() call names. The ESP32's SPI peripherals route
// their pins through an internal GPIO matrix, so `sdSPI.begin(SD_SCK_PIN,
// ...)` — called in setup() AFTER the LoRa radio's own SPI.begin()/
// radio.begin() — silently REPROGRAMS that shared peripheral's pin
// routing to the SD card's pins, out from under the LoRa radio that had
// just configured it. Confirmed via real hardware symptoms that only
// make sense with this explanation: radio.begin() (which runs first)
// kept reporting success, but EVERY subsequent radio.startTransmit()
// call in loop() (which runs long after initSdCard() has already
// hijacked the shared peripheral) failed with a generic RadioLib error
// — the SPI traffic intended for the SX1262 was actually going out on
// the SD card's pins by then. Fixed by moving the SD card onto `HSPI`
// (SPI3_HOST) instead — the ESP32-S3's OTHER general-purpose SPI
// peripheral, genuinely independent hardware from FSPI/SPI2_HOST, not
// just a different pin assignment on the same one.
SPIClass sdSPI(HSPI);
bool sdReady = false;
File logFile;

// Second hardware I2C bus (the ESP32-S3 has two independent I2C
// controllers) for the RTC — kept separate from the default `Wire` object
// used by the IMU/ADS1115 above, since the DS1307's fixed 0x68 address
// would collide with the IMU on that bus. See RTC_SDA_PIN's own comment.
TwoWire   rtcWire(1);
RTC_DS1307 rtc;
bool       rtcReady = false;

// SX1262 radio (NSS, DIO1, RST, BUSY)
SX1262 radio = new Module(LORA_NSS, LORA_DIO1, LORA_RST, LORA_BUSY);
bool   loraReady   = false;

// ── Async LoRa TX ───────────────────────────────────────────────────
// Kept even at SF9/BW125's ~218ms airtime — non-blocking TX is
// strictly safer regardless of spreading factor/bandwidth and costs
// nothing to keep. Same interrupt-driven pattern greenpower_receiver
// already uses proven on its RX side (setPacketReceivedAction), mirrored
// here for TX instead of RX.
volatile bool loraTxDoneFlag = false;
void IRAM_ATTR setLoraTxFlag() { loraTxDoneFlag = true; }
// Only ever read/written from loop() (unlike loraTxDoneFlag, which the ISR
// also touches) — true from the moment startTransmit() successfully kicks
// off a transmission until finishTransmit() has been called for it.
bool loraTxInFlight = false;

// ESP-NOW peer (steering wheel display)
static const uint8_t PEER_MAC[6] = ESPNOW_PEER_MAC;
bool   espNowReady = false;

static telemetry_packet_t pkt = {};


// ════════════════════════════════════════════════════════════════════
//  TIMING
// ════════════════════════════════════════════════════════════════════

// 200ms (5Hz) → 250ms (4Hz), per explicit request — traded update rate
// for real LoRa margin (see the ⚠️ TWELFTH pass note near
// LORA_TX_INTERVAL_MS for the full reasoning). This is a genuine sensor
// sample-rate change, not just a radio-side one — the sensors themselves
// are now read 4x/sec instead of 5x/sec.
static const uint32_t SENSOR_INTERVAL_MS   = 250;   // 4 Hz
static const uint32_t RPM_CALC_INTERVAL_MS = 250;   // 4 Hz — matches SENSOR_INTERVAL_MS so RPM isn't stale between packets
static uint32_t lastSensorMs = 0;
static uint32_t lastRpmMs    = 0;
static uint32_t lastLoraTxMs = 0;
static uint32_t lastEspNowMs = 0;


// ════════════════════════════════════════════════════════════════════
//  RPM  (laser break-beam interrupt sensors, unbranded — polarity unknown)
//
//  Measured by PERIOD, not by counting edges in a window. Counting edges
//  over a fixed window only gives whole-number resolution — at low pulse
//  rates each extra edge jumps the computed RPM by a large fixed step
//  (with the old windowed-count method: 60 / (RPM_CALC_INTERVAL_MS/1000)
//  per raw edge). Timing the gap between pulses instead gives a smooth,
//  continuous value that updates on every single pulse.
//
//  Edges are still counted with CHANGE (polarity-agnostic — works whether
//  the sensor idles HIGH or LOW). Since one full beam-block event produces
//  two edges, only every OTHER debounced edge marks a full slot-pass
//  boundary; the period between two such boundaries is a genuine full-pulse
//  period regardless of which physical direction (rising/falling) that is.
//  If RPM reads exactly double the real value once you can spin a disc by
//  hand, flip RPM_COUNT_BOTH_EDGES to 0 and pick a single edge instead.
//
//  Debounce is a short, fixed electrical-noise floor only (not meant to
//  filter real slot pulses) — tune down if RPM looks capped at high speed.
// ════════════════════════════════════════════════════════════════════

#define RPM_COUNT_BOTH_EDGES  1          // 1 = CHANGE, every-other-edge = pulse boundary. 0 = single edge = pulse boundary.
#define RPM_SINGLE_EDGE_MODE  FALLING    // used only if RPM_COUNT_BOTH_EDGES == 0
#define RPM_DEBOUNCE_US       1500       // electrical noise floor, not a real-signal filter
#define RPM_STALE_MS           1000      // no pulse for this long = report 0 instead of freezing

volatile uint32_t motorEdges     = 0;    // raw edge count — diagnostics only, not used in RPM math
volatile uint32_t wheelEdges     = 0;
volatile uint8_t  motorParity    = 0;
volatile uint8_t  wheelParity    = 0;
volatile int64_t  motorPulseUs   = 0;    // timestamp of the last pulse boundary
volatile int64_t  wheelPulseUs   = 0;
volatile int64_t  motorPeriodUs  = 0;    // time between the last two pulse boundaries
volatile int64_t  wheelPeriodUs  = 0;

void IRAM_ATTR motorRpmISR() {
    static int64_t lastUs = 0;
    int64_t now = esp_timer_get_time();
    if (now - lastUs < RPM_DEBOUNCE_US) return;
    lastUs = now;
    motorEdges++;

#if RPM_COUNT_BOTH_EDGES
    motorParity ^= 1;
    if (motorParity != 0) return;   // wait for the matching second edge of this pulse
#endif
    if (motorPulseUs != 0) motorPeriodUs = now - motorPulseUs;
    motorPulseUs = now;
}
void IRAM_ATTR wheelRpmISR() {
    static int64_t lastUs = 0;
    int64_t now = esp_timer_get_time();
    if (now - lastUs < RPM_DEBOUNCE_US) return;
    lastUs = now;
    wheelEdges++;

#if RPM_COUNT_BOTH_EDGES
    wheelParity ^= 1;
    if (wheelParity != 0) return;
#endif
    if (wheelPulseUs != 0) wheelPeriodUs = now - wheelPulseUs;
    wheelPulseUs = now;
}

static float    motorRpm = 0.0f;
static float    wheelRpm = 0.0f;
// Raw edge counts since the last dump, kept only for the serial diagnostic
// print — lets you see edges arriving in real time (or confirm they never
// do, which points at wiring/power, not code).
static uint32_t lastMotorEdges = 0;
static uint32_t lastWheelEdges = 0;

static float periodToRpm(int64_t periodUs, int64_t lastPulseUs, uint32_t slotsPerRev) {
    int64_t nowUs = esp_timer_get_time();
    if (lastPulseUs == 0 || periodUs <= 0 || (nowUs - lastPulseUs) > (RPM_STALE_MS * 1000)) {
        return 0.0f;   // never pulsed yet, or stopped — don't freeze on the last speed
    }
    return 60.0e6f / ((float)periodUs * slotsPerRev);
}

static void updateRpm() {
    uint32_t now     = millis();
    uint32_t elapsed = now - lastRpmMs;
    if (elapsed < RPM_CALC_INTERVAL_MS) return;   // this only paces the dump/refresh rate now
    lastRpmMs = now;

    noInterrupts();
    uint32_t  me           = motorEdges;  motorEdges = 0;
    uint32_t  we           = wheelEdges;  wheelEdges = 0;
    int64_t   motorPeriod  = motorPeriodUs;
    int64_t   wheelPeriod  = wheelPeriodUs;
    int64_t   motorLastPulse = motorPulseUs;
    int64_t   wheelLastPulse = wheelPulseUs;
    interrupts();

    lastMotorEdges = me;
    lastWheelEdges = we;

    motorRpm = periodToRpm(motorPeriod, motorLastPulse, MOTOR_SLOTS_PER_REV);
    wheelRpm = periodToRpm(wheelPeriod, wheelLastPulse, WHEEL_SLOTS_PER_REV);
}


// ════════════════════════════════════════════════════════════════════
//  SENSOR READERS — ADS1115 (voltage dividers + current sensor)
// ════════════════════════════════════════════════════════════════════

// Single-ended read on A0/A1 through a 5:1 divider, gain set wide enough
// to cover the divider's ~5V max output without clipping. Each channel
// passes its own calibrated ratio since the two dividers aren't identical.
static float readDividerVoltage(uint8_t channel, float dividerRatio) {
    ads.setGain(GAIN_TWOTHIRDS);              // ±6.144V FSR
    int16_t raw  = ads.readADC_SingleEnded(channel);
    float   vadc = ads.computeVolts(raw);
    return vadc / dividerRatio;               // undo the divider
}

// Differential A2(Vout) - A3(Vref) — cancels the sensor's own zero offset
// in hardware instead of relying on an assumed constant.
static float readCurrentAmps() {
    ads.setGain(GAIN_ONE);                    // ±4.096V FSR — better resolution
    int16_t raw   = ads.readADC_Differential_2_3();
    float   vdiff = ads.computeVolts(raw);
    return vdiff / CURRENT_SENS;
}


// ════════════════════════════════════════════════════════════════════
//  SENSOR READER — DS18B20 (GPIO6, 1-Wire digital)
// ════════════════════════════════════════════════════════════════════

// Raw Celsius reading from the last conversion, kept only for the serial
// diagnostic dump — DEVICE_DISCONNECTED_C (-127) here means the sensor
// didn't respond (check the pull-up resistor and data-line wiring).
static float lastTempRawC = 0.0f;

static float readTempF() {
    // requestTemperatures() blocks until conversion finishes — ~750 ms at the
    // default 12-bit resolution, or ~94 ms at 9-bit (set in setup()). Fine at
    // this sketch's 200 ms sensor-poll cadence.
    tempSensor.requestTemperatures();
    float tempC = tempSensor.getTempCByIndex(0);
    lastTempRawC = tempC;

    if (tempC == DEVICE_DISCONNECTED_C) {
        return NAN;   // caller/print sees this as clearly invalid, not a bogus number
    }
    return tempC * 1.8f + 32.0f;
}


// ════════════════════════════════════════════════════════════════════
//  GPS POLL  (call every loop — feeds TinyGPS++ incrementally)
// ════════════════════════════════════════════════════════════════════

static void pollGps() {
    while (Serial1.available()) {
        gps.encode(Serial1.read());
    }
}


// ════════════════════════════════════════════════════════════════════
//  ESC UART PARSER  (Serial2, from ../esc controller/throttle_controller.ino)
//  Format: mode,state,setpointPct,livePct,rampPct
// ════════════════════════════════════════════════════════════════════

struct EscData {
    char  mode[8];       // matches telemetry_packet_t.esc_mode size
    char  state[8];      // matches telemetry_packet_t.esc_state size
    float setpointPct;
    float livePct;
    float rampPct;
    bool  valid;
};

static EscData esc = {};

// String → packet-code lookups — only needed at the point esc.mode/esc.state
// (parsed off the UART line, still real strings — see EscData above) get
// copied into the packed telemetry_packet_t for LoRa TX. Everywhere else in
// this sketch (SD log, ESP-NOW, serial dump) keeps using esc.mode/esc.state
// directly as strings — only the LoRa packet itself needed shrinking. See
// PKT_ESC_MODE_*/PKT_ESC_STATE_* in config.h for the values these map to.
static uint8_t escModeToCode(const char* mode) {
    if (strcmp(mode, "ECO")    == 0) return PKT_ESC_MODE_ECO;
    if (strcmp(mode, "SPORT")  == 0) return PKT_ESC_MODE_SPORT;
    if (strcmp(mode, "NORMAL") == 0) return PKT_ESC_MODE_NORMAL;
    return PKT_ESC_MODE_UNKNOWN;   // unrecognized string — shouldn't happen, but don't guess
}
static uint8_t escStateToCode(const char* state) {
    if (strcmp(state, "IDLE")  == 0) return PKT_ESC_STATE_IDLE;
    if (strcmp(state, "REENG") == 0) return PKT_ESC_STATE_REENG;
    if (strcmp(state, "RAMP")  == 0) return PKT_ESC_STATE_RAMP;
    if (strcmp(state, "HOLD")  == 0) return PKT_ESC_STATE_HOLD;
    return PKT_ESC_STATE_UNKNOWN;
}

static void parseEscLine(char* line) {
    char* tok = strtok(line, ",");
    if (!tok) return;
    strncpy(esc.mode, tok, sizeof(esc.mode) - 1);
    esc.mode[sizeof(esc.mode) - 1] = '\0';

    tok = strtok(nullptr, ",");
    if (!tok) return;
    strncpy(esc.state, tok, sizeof(esc.state) - 1);
    esc.state[sizeof(esc.state) - 1] = '\0';

    tok = strtok(nullptr, ",");
    if (!tok) return;
    esc.setpointPct = atof(tok);

    tok = strtok(nullptr, ",");
    if (!tok) return;
    esc.livePct = atof(tok);

    tok = strtok(nullptr, ",");
    if (!tok) return;
    esc.rampPct = atof(tok);

    esc.valid = true;
}

static void pollEsc() {
    static char    buf[64];
    static uint8_t idx = 0;

    while (Serial2.available()) {
        char c = Serial2.read();
        if (c == '\n') {
            buf[idx] = '\0';
            parseEscLine(buf);
            idx = 0;
        } else if (c != '\r' && idx < sizeof(buf) - 1) {
            buf[idx++] = c;
        }
    }
}


// ════════════════════════════════════════════════════════════════════
//  RTC  (Elegoo DS1307-V03, own I2C bus — see RTC_SDA_PIN's own comment)
//  Only used to stamp the SD log with real wall-clock time — nothing in
//  the LoRa/ESP-NOW packet depends on it, so a missing/dead RTC doesn't
//  affect telemetry, only the SD log's timestamp column.
// ════════════════════════════════════════════════════════════════════

static void initRtc() {
    rtcWire.begin(RTC_SDA_PIN, RTC_SCL_PIN);
    if (!rtc.begin(&rtcWire)) {
        Serial.println("[WARN] RTC (DS1307) not detected on I2C (0x68, second bus) — SD log will fall back to millis() only");
        return;
    }
    if (!rtc.isrunning()) {
        // First-ever power-up (or a dead backup battery) — the DS1307
        // starts at an arbitrary/zeroed time until told otherwise. Set it
        // once from the PC's clock at compile time; after that its own
        // backup battery keeps it running across power-cycles, so this
        // branch shouldn't normally fire again unless that battery is
        // removed or dies.
        Serial.println("[WARN] RTC not running — setting from compile time (check backup battery if this happens again)");
        rtc.adjust(DateTime(F(__DATE__), F(__TIME__)));
    }
    rtcReady = true;
    DateTime now = rtc.now();
    Serial.printf("[OK]   RTC (DS1307)  %04d-%02d-%02d %02d:%02d:%02d\n",
                  now.year(), now.month(), now.day(),
                  now.hour(), now.minute(), now.second());
}

// Formats the RTC's current time as "YYYY-MM-DD HH:MM:SS" into buf, or
// "NO_RTC" if the RTC was never detected — keeps the SD log's column count
// consistent either way rather than shifting columns when the RTC is absent.
static void getRtcTimestamp(char* buf, size_t len) {
    if (!rtcReady) {
        snprintf(buf, len, "NO_RTC");
        return;
    }
    DateTime now = rtc.now();
    snprintf(buf, len, "%04d-%02d-%02d %02d:%02d:%02d",
             now.year(), now.month(), now.day(),
             now.hour(), now.minute(), now.second());
}


// ════════════════════════════════════════════════════════════════════
//  SD CARD LOGGING  (local backup — independent of LoRa/ESP-NOW)
//  A separate, persistent record of everything this sender sees, kept
//  entirely on the vehicle regardless of whether the LoRa link to the
//  base station ever actually connects. Useful on its own (post-run
//  analysis straight off the card) and as a fallback if the radio link
//  drops out mid-run — nothing here depends on LoRa/ESP-NOW being up.
// ════════════════════════════════════════════════════════════════════

// One new file per power-cycle (LOG001.CSV, LOG002.CSV, ...) rather than
// one giant always-appended file — keeps each run's data separate for
// easier post-race analysis, same reasoning telemetry_web's own
// session-boundary logic uses for a similar problem server-side. Scans
// for the first filename that doesn't already exist rather than assuming
// LOG001 is free — the card persists across power cycles, so a fresh
// boot after previous runs needs to find where the last one left off.
static bool openNextLogFile() {
    char name[16];
    for (int i = 1; i <= 999; i++) {
        snprintf(name, sizeof(name), "/LOG%03d.CSV", i);
        if (!SD.exists(name)) {
            logFile = SD.open(name, FILE_WRITE);
            if (!logFile) return false;
            Serial.printf("[OK]   SD log file: %s\n", name);
            return true;
        }
    }
    return false;   // 999 log files already on the card — extremely unlikely, but don't loop forever
}

static void initSdCard() {
    sdSPI.begin(SD_SCK_PIN, SD_MISO_PIN, SD_MOSI_PIN, SD_CS_PIN);
    if (!SD.begin(SD_CS_PIN, sdSPI)) {
        Serial.println("[WARN] SD card not detected — local logging disabled (LoRa/ESP-NOW unaffected)");
        return;
    }
    if (!openNextLogFile()) {
        Serial.println("[WARN] SD card present but couldn't open a log file — local logging disabled");
        return;
    }
    // Header row — column order matches the fields written in logToSD()
    // below. timestamp is real wall-clock time from the DS1307 RTC (or
    // "NO_RTC" for every row if it was never detected); millis_ms is this
    // board's own uptime clock, kept alongside it since it's still useful
    // for computing relative timing/intervals within one run regardless of
    // whether the RTC is present or correctly set.
    logFile.println("timestamp,millis_ms,flags,speed_mph,latitude,longitude,hdop,satellites,"
                     "temp_f,batt_volt,motor_volt,current_a,"
                     "pitch_deg,accel_g,lateral_g,vertical_g,"
                     "motor_rpm,wheel_rpm,"
                     "esc_mode,esc_state,esc_setpoint_pct,esc_live_pct,esc_ramp_pct");
    logFile.flush();
    sdReady = true;
    Serial.println("[OK]   SD card logging active");
}

// Called once per SENSOR_INTERVAL_MS tick (see loop()), right after
// updateSensors() — logs the exact same `pkt` LoRa/ESP-NOW would send,
// so the card's record and the transmitted telemetry never disagree.
// flush()ed on every single write, not batched — at 5Hz this is a small
// amount of data, and the whole point of a local backup is surviving a
// sudden power loss (a real, plausible failure mode for a race vehicle);
// data sitting in an unflushed buffer when power cuts is data this log
// was specifically supposed to protect against losing.
static void logToSD() {
    if (!sdReady) return;
    char ts[24];
    getRtcTimestamp(ts, sizeof(ts));
    // esc.mode/esc.state (not the packed-bit esc_mode in pkt.flags or
    // esc_state in pkt.sat_esc_state) — the SD log is local-only, never
    // transmitted, so it can just use the real strings straight from the
    // last parsed ESC line instead of the LoRa packet's compact numeric
    // codes. "---" matches espNowSend()'s own fallback for "no ESC line
    // ever parsed" (mirrors PKT_FLAG_ESC_VALID).
    bool escValid = pkt.flags & PKT_FLAG_ESC_VALID;
    float hdopOut = (pkt.hdop_x10 == PKT_HDOP_NO_FIX) ? 99.9f : (pkt.hdop_x10 / 10.0f);
    // Decoded back to human units from pkt's compressed fields — see config.h's
    // "Fixed-point compression" block. This is the same reduced-resolution
    // data that was transmitted, not a separate higher-precision copy.
    float tempFOut = (pkt.temp_f == PKT_TEMP_NO_READING) ? NAN : (float)pkt.temp_f;
    uint16_t battVoltRawOut, motorVoltRawOut, currentRawOut;
    pktUnpackVoltCur(pkt.volt_cur_pack, &battVoltRawOut, &motorVoltRawOut, &currentRawOut);
    logFile.printf(
        "%s,%lu,%u,%.2f,%.6f,%.6f,%.1f,%u,"
        "%.1f,%.2f,%.2f,%.2f,"
        "%.2f,%.3f,%.3f,%.3f,"
        "%.0f,%.0f,"
        "%s,%s,%.1f,%.1f,%.1f\n",
        ts, (unsigned long)millis(), pkt.flags, pkt.speed_mph_x10 / PKT_SCALE_SPEED, pkt.latitude, pkt.longitude, hdopOut, pktGetSatellites(pkt.sat_esc_state),
        tempFOut, battVoltRawOut / PKT_SCALE_VOLT, motorVoltRawOut / PKT_SCALE_VOLT, currentRawOut / PKT_SCALE_CURRENT,
        (float)pkt.pitch_deg, pkt.accel_g_x1000 / PKT_SCALE_G, pkt.lateral_g_x1000 / PKT_SCALE_G, pkt.vertical_g_x1000 / PKT_SCALE_G,
        (float)pkt.motor_rpm, pkt.wheel_rpm_x10 / PKT_SCALE_WHEEL_RPM,
        escValid ? esc.mode : "---", escValid ? esc.state : "---",
        (float)pkt.esc_setpoint_pct, (float)pkt.esc_live_pct, (float)pkt.esc_ramp_pct
    );
    logFile.flush();
}


// ════════════════════════════════════════════════════════════════════
//  SENSOR UPDATE  (called at SENSOR_INTERVAL_MS)
// ════════════════════════════════════════════════════════════════════

// Packs a float HDOP into the packet's single-byte HDOP×10 field — see
// PKT_HDOP_NO_FIX's own comment in config.h for why this isn't a float
// anymore. Clamped to 254 (25.4 HDOP) rather than wrapping/overflowing on
// an unexpectedly large value; 255 is reserved for "no fix".
static uint8_t packHdop(float hdop) {
    long v = lroundf(hdop * 10.0f);
    if (v < 0)   v = 0;
    if (v > 254) v = 254;
    return (uint8_t)v;
}

static void updateGps() {
    if (gps.location.isValid() && gps.location.age() < 2000) {
        pkt.latitude   = (float)gps.location.lat();
        pkt.longitude  = (float)gps.location.lng();
        pkt.speed_mph_x10 = pktEncU16((float)gps.speed.mph(), PKT_SCALE_SPEED);
        pkt.hdop_x10   = gps.hdop.isValid() ? packHdop((float)gps.hdop.hdop()) : PKT_HDOP_NO_FIX;
        pkt.sat_esc_state = pktSetSatellites(pkt.sat_esc_state, (uint8_t)gps.satellites.value());
        pkt.flags     |=  PKT_FLAG_GPS_VALID;
    } else {
        pkt.flags &= ~PKT_FLAG_GPS_VALID;
    }
}

static void updateImu() {
    sensors_event_t accelEvt, gyroEvt, tempEvt;
    if (!mpu.getEvent(&accelEvt, &gyroEvt, &tempEvt)) return;

    float ax = accelEvt.acceleration.x;  // m/s²
    float ay = accelEvt.acceleration.y;
    float az = accelEvt.acceleration.z;

    pkt.accel_g_x1000    = pktEncI16(ax / 9.80665f, PKT_SCALE_G);   // forward / braking
    pkt.lateral_g_x1000  = pktEncI16(ay / 9.80665f, PKT_SCALE_G);   // cornering
    pkt.vertical_g_x1000 = pktEncI16(az / 9.80665f, PKT_SCALE_G);   // vertical

    // Static tilt angle from accelerometer (accurate at rest, noisy while
    // moving) — roll and yaw were removed per explicit request (not needed);
    // pitch is the only orientation angle still tracked. Yaw's own gyro-
    // integration state (lastGyroMs) was removed along with it — nothing
    // else in this file used that variable.
    pkt.pitch_deg = pktEncI8(atan2f(-ax, sqrtf(ay * ay + az * az)) * 57.29578f);

    pkt.flags |= PKT_FLAG_IMU_VALID;
}

static void updateSensors() {
    updateGps();
    updateImu();
    updateRpm();

    // pkt.epoch_time no longer exists — removed entirely per explicit
    // request (see config.h's own comment on the field's removal). The
    // RTC is still read for the local SD log (logToSD()'s getRtcTimestamp()
    // call), just never packed into the transmitted packet anymore.
    float tempF     = readTempF();
    pkt.temp_f      = isnan(tempF) ? PKT_TEMP_NO_READING : pktEncI8(tempF);
    // batt_volt/motor_volt/current_a are now cross-byte packed into
    // pkt.volt_cur_pack — encode each to its raw (12/12/14-bit) value
    // first, then pack all three together in one call. See
    // pktEncVolt12()/pktEncCurrent14()/pktPackVoltCur()'s own comments in
    // config.h for the real-world 0-30V/0-120A bounds this is built on.
    uint16_t motorVoltRaw = pktEncVolt12(readDividerVoltage(ADS_MOTOR_V_CH, VDIV_RATIO_MOTOR));
    uint16_t battVoltRaw  = pktEncVolt12(readDividerVoltage(ADS_BATT_V_CH, VDIV_RATIO_BATT));
    uint16_t currentRaw   = pktEncCurrent14(readCurrentAmps());
    pktPackVoltCur(pkt.volt_cur_pack, battVoltRaw, motorVoltRaw, currentRaw);
    pkt.motor_rpm       = pktEncU16(motorRpm, 1.0f);
    pkt.wheel_rpm_x10   = pktEncU16(wheelRpm, PKT_SCALE_WHEEL_RPM);
    pkt.flags      |= PKT_FLAG_CUR_VALID;

    // ESC fields — copied in from the last successfully parsed UART line
    // (pollEsc() runs every loop() iteration, independent of this 200ms tick,
    // so this is just picking up whatever's most recent, not triggering a read).
    if (esc.valid) {
        pkt.flags            = pktSetEscMode(pkt.flags, escModeToCode(esc.mode));
        pkt.sat_esc_state    = pktSetEscState(pkt.sat_esc_state, escStateToCode(esc.state));
        pkt.esc_setpoint_pct = pktEncPct(esc.setpointPct);
        pkt.esc_live_pct     = pktEncPct(esc.livePct);
        pkt.esc_ramp_pct     = pktEncPct(esc.rampPct);
        pkt.flags           |= PKT_FLAG_ESC_VALID;
    } else {
        pkt.flags         = pktSetEscMode(pkt.flags, PKT_ESC_MODE_UNKNOWN);
        pkt.sat_esc_state = pktSetEscState(pkt.sat_esc_state, PKT_ESC_STATE_UNKNOWN);
        pkt.flags &= ~PKT_FLAG_ESC_VALID;
    }
}


// ════════════════════════════════════════════════════════════════════
//  LORA TX
// ════════════════════════════════════════════════════════════════════

// Kicks off a transmission and returns immediately — does NOT block for the
// transmit's airtime (~218ms at SF9/BW125). See loraTxDoneFlag's own
// comment (near the radio's declaration) for why this is kept anyway.
// Completion is picked up later by checkLoraTxComplete(), called every
// loop() iteration independent of LORA_TX_INTERVAL_MS's own timing.
static void loRaTx() {
    if (!loraReady) return;
    if (loraTxInFlight) {
        // The previous transmission hasn't finished yet — LORA_TX_INTERVAL_MS
        // still has real margin above SF9/BW125's actual airtime (~32ms)
        // so this should be rare, not a normal steady-state occurrence. Skip this
        // cycle rather than call startTransmit() on top of an in-progress
        // one (undefined radio state) or block waiting for it.
        Serial.println("  [LoRa] TX skipped — previous transmit still in flight");
        return;
    }

    int state = radio.startTransmit((uint8_t*)&pkt, sizeof(pkt));
    if (state == RADIOLIB_ERR_NONE) {
        loraTxInFlight = true;
    } else {
        Serial.printf("  [LoRa] startTransmit() ERR %d\n", state);
    }
}

// Called every loop() iteration (cheap — one volatile bool check on every
// pass when nothing's pending) so a completed transmission is noticed
// promptly regardless of where LORA_TX_INTERVAL_MS's own next check lands.
static void checkLoraTxComplete() {
    if (!loraTxDoneFlag) return;
    loraTxDoneFlag = false;

    // finishTransmit() is the required cleanup call after an async
    // startTransmit() (puts the radio back into standby, clears IRQ flags)
    // — RadioLib's documented pairing, same idea as the receiver always
    // re-arming startReceive() after every readData(), successful or not.
    int state = radio.finishTransmit();
    loraTxInFlight = false;

    if (state == RADIOLIB_ERR_NONE) {
        Serial.printf("  [LoRa] TX OK  %u bytes  RSSI:%.0f dBm\n",
                      sizeof(pkt), radio.getRSSI());
    } else {
        Serial.printf("  [LoRa] TX ERR %d\n", state);
    }
}


// ════════════════════════════════════════════════════════════════════
//  ESP-NOW TX
//  Format: speed_mph,batV,rpm,amps,mode,state,setpoint%,live%,ramp%
//  Same format as mock_sender, so display_receiver doesn't care which
//  sender is live. mode/state/percent fields come from the real ESC UART
//  link when available; "---"/0 placeholders only if no ESC line has ever
//  been parsed (PKT_FLAG_ESC_VALID not set).
// ════════════════════════════════════════════════════════════════════

static void espNowSend() {
    if (!espNowReady) return;

    bool escValid = pkt.flags & PKT_FLAG_ESC_VALID;

    // This CSV's own on-the-wire format is unchanged (still speed_mph,batV,
    // rpm,amps,... as plain human-readable text over ESP-NOW) — only pkt's
    // internal storage got compressed, so every value read out of it here
    // is decoded back to its real unit first, same as the LoRa-side debug
    // dump/JSON above.
    uint16_t battVoltRaw, motorVoltRaw, currentRaw;
    pktUnpackVoltCur(pkt.volt_cur_pack, &battVoltRaw, &motorVoltRaw, &currentRaw);
    char payload[128];
    snprintf(payload, sizeof(payload),
        "%.1f,%.2f,%u,%.1f,%s,%s,%.1f,%.1f,%.1f",
        pkt.speed_mph_x10 / PKT_SCALE_SPEED,
        battVoltRaw / PKT_SCALE_VOLT,
        pkt.motor_rpm,
        currentRaw / PKT_SCALE_CURRENT,
        escValid ? esc.mode  : "---",
        escValid ? esc.state : "---",
        escValid ? (float)pkt.esc_setpoint_pct : 0.0f,
        escValid ? (float)pkt.esc_live_pct     : 0.0f,
        escValid ? (float)pkt.esc_ramp_pct     : 0.0f
    );

    esp_err_t result = esp_now_send(PEER_MAC, (uint8_t*)payload, strlen(payload));
    Serial.printf("  [ESP-NOW] %s  \"%s\"\n",
                  result == ESP_OK ? "TX OK" : "TX ERR", payload);
}


// ════════════════════════════════════════════════════════════════════
//  SETUP
// ════════════════════════════════════════════════════════════════════

void setup() {
    Serial.begin(115200);
    uint32_t t0 = millis();
    while (!Serial && millis() - t0 < 3000) delay(10);  // wait up to 3s for serial monitor
    Serial.println("\n[BOOT] Greenpower Sender V3 (breadboard, LoRa + ESP-NOW)");

    // GPS
    Serial1.begin(GPS_BAUD, SERIAL_8N1, GPS_RX_PIN, GPS_TX_PIN);
    Serial.printf("[OK]   GPS    Serial1  RX=%d TX=%d @ %d\n",
                  GPS_RX_PIN, GPS_TX_PIN, GPS_BAUD);

    // ESC controller
    Serial2.begin(ESC_BAUD, SERIAL_8N1, ESC_RX_PIN, ESC_TX_PIN);
    Serial.printf("[OK]   ESC    Serial2  RX=%d TX=%d @ %d\n",
                  ESC_RX_PIN, ESC_TX_PIN, ESC_BAUD);

    // Enable external sensor power rail (GPIO36, active LOW) — Heltec V4
    pinMode(VEXT_CTRL, OUTPUT);
    digitalWrite(VEXT_CTRL, LOW);
    delay(500);                        // give rail plenty of time to stabilise

    // I2C — SDA=17, SCL=18  (IMU + ADS1115)
    Wire.begin(I2C_SDA_PIN, I2C_SCL_PIN);
    delay(100);

    // IMU (HW-123, MPU6050-compatible)
    if (!mpu.begin(MPU6050_I2CADDR_DEFAULT, &Wire)) {
        Serial.println("[WARN] IMU not detected on I2C (0x68)");
    } else {
        mpu.setAccelerometerRange(MPU6050_RANGE_4_G);
        mpu.setGyroRange(MPU6050_RANGE_500_DEG);
        mpu.setFilterBandwidth(MPU6050_BAND_21_HZ);
        Serial.println("[OK]   IMU (HW-123)");
    }

    // RPM interrupt sensors
    pinMode(MOTOR_RPM_PIN, RPM_PIN_MODE);
    pinMode(WHEEL_RPM_PIN, RPM_PIN_MODE);
#if RPM_COUNT_BOTH_EDGES
    attachInterrupt(digitalPinToInterrupt(MOTOR_RPM_PIN), motorRpmISR, CHANGE);
    attachInterrupt(digitalPinToInterrupt(WHEEL_RPM_PIN), wheelRpmISR, CHANGE);
#else
    attachInterrupt(digitalPinToInterrupt(MOTOR_RPM_PIN), motorRpmISR, RPM_SINGLE_EDGE_MODE);
    attachInterrupt(digitalPinToInterrupt(WHEEL_RPM_PIN), wheelRpmISR, RPM_SINGLE_EDGE_MODE);
#endif
    lastRpmMs = millis();
    Serial.printf("[OK]   RPM     motor=GPIO%d(idle=%d)  wheel=GPIO%d(idle=%d)\n",
                  MOTOR_RPM_PIN, digitalRead(MOTOR_RPM_PIN),
                  WHEEL_RPM_PIN, digitalRead(WHEEL_RPM_PIN));

    // DS18B20 — 9-bit resolution keeps conversion time short (~94 ms) so it
    // doesn't eat into the 200 ms sensor-poll cadence; 12-bit default is ~750 ms.
    tempSensor.begin();
    tempSensor.setResolution(9);
    Serial.printf("[OK]   Temp    DS18B20 pin=GPIO%d  count=%d\n",
                  TEMP_PROBE_PIN, tempSensor.getDeviceCount());

    // ADS1115 — motorVolt(A0) / battVolt(A1) / current sensor(A2-A3 diff)
    if (!ads.begin(ADS_I2C_ADDR, &Wire)) {
        Serial.println("[WARN] ADS1115 not detected on I2C (0x48)");
    } else {
        Serial.printf("[OK]   ADS1115  0x%02X  A0=motorV A1=battV A2/A3=current\n",
                      ADS_I2C_ADDR);
    }

    // WiFi (STA, no AP connection) + ESP-NOW
    WiFi.mode(WIFI_STA);
    WiFi.disconnect();
    if (esp_now_init() != ESP_OK) {
        Serial.println("[WARN] ESP-NOW init failed");
    } else {
        esp_now_peer_info_t peer = {};
        memcpy(peer.peer_addr, PEER_MAC, 6);
        peer.channel = 0;
        peer.encrypt = false;
        if (esp_now_add_peer(&peer) != ESP_OK) {
            Serial.println("[WARN] ESP-NOW add peer failed");
        } else {
            espNowReady = true;
            Serial.printf("[OK]   ESP-NOW → %02X:%02X:%02X:%02X:%02X:%02X\n",
                          PEER_MAC[0], PEER_MAC[1], PEER_MAC[2],
                          PEER_MAC[3], PEER_MAC[4], PEER_MAC[5]);
        }
    }

    // Heltec V4 antenna front-end enable — MUST happen before radio.begin()
    // below, so the antenna path is actually live from the radio's very
    // first transmit/receive attempt onward. See FEM_EN_PIN's own comment
    // (near RTC_SDA_PIN above) for the full story and sourcing.
    pinMode(FEM_EN_PIN, OUTPUT);
    digitalWrite(FEM_EN_PIN, HIGH);   // CSD — power up the front-end module
    pinMode(FEM_CPS_PIN, OUTPUT);
    digitalWrite(FEM_CPS_PIN, HIGH);  // CPS — full-power PA mode for TX
    Serial.println("[OK]   Heltec V4 antenna front-end enabled (FEM_EN/FEM_CPS)");

    // SX1262 LoRa radio
    SPI.begin(LORA_SCK, LORA_MISO, LORA_MOSI, LORA_NSS);
    int loraState = radio.begin(
        LORA_FREQ_MHZ,        // 915.0 MHz
        125.0,                // bandwidth kHz — paired with SF9 below for MAX range within the new 250ms budget, with real (~32ms) margin — see the ⚠️ TWELFTH pass note above LORA_TX_INTERVAL_MS for the full candidate comparison and why this beat the theoretical-best-but-razor-thin-margin option
        9,                    // spreading factor — SF9 (was SF7); MUST match the receiver's copy exactly or packets won't decode. Not a hang risk — see the ✅ CORRECTION note above; this is a new SF for this project, not a newly-risky one
        5,                    // coding rate 4/5
        LORA_SYNC_WORD,       // 0xF3
        LORA_TX_POWER_DBM,    // 22 dBm
        LORA_PREAMBLE_SYMBOLS // preamble length — see its own comment in config.h
    );
    if (loraState != RADIOLIB_ERR_NONE) {
        Serial.printf("[WARN] SX1262 init failed  code=%d\n", loraState);
    } else {
        radio.setDio2AsRfSwitch(true);   // required on Heltec V4
        radio.setPacketSentAction(setLoraTxFlag);   // async TX completion — kept even at this short airtime, see loraTxDoneFlag's own comment

        // Implicit header mode — every packet is a fixed sizeof(telemetry_packet_t)
        // bytes, so there's nothing for an explicit LoRa header to usefully
        // describe (it normally carries the payload length + coding rate for
        // a receiver that doesn't already know them). Skipping it removes a
        // real chunk of per-packet payload-symbol overhead for free — no
        // range or reliability cost, since the receiver already knows the
        // exact length via the same shared config.h struct. MUST match the
        // receiver's own implicitHeader() call exactly (same length) or
        // packets won't decode — see receiver's radio.begin() block.
        int hdrState = radio.implicitHeader(sizeof(telemetry_packet_t));
        if (hdrState != RADIOLIB_ERR_NONE) {
            Serial.printf("[WARN] implicitHeader() failed  code=%d — falling back to explicit header (still works, just ~1.3ms/packet slower)\n", hdrState);
        }

        loraReady = true;
        Serial.printf("[OK]   SX1262  915 MHz  SF9  BW125  22dBm  implicit-hdr  preamble=%u\n", LORA_PREAMBLE_SYMBOLS);
    }

    // ⚠️ RTC temporarily DISABLED — not removed, just not called. Per
    // explicit request: GPIO2 (RTC_SCL_PIN) is needed for the Heltec V4
    // antenna front-end fix below (FEM_EN/CSD — see that section's own
    // comment for the full story: a -120dBm reading at 15ft traced to
    // this board's external antenna amplifier chip needing to be
    // explicitly enabled, which RadioLib has no way to know about).
    // Skipping initRtc() entirely means rtcWire.begin(RTC_SDA_PIN,
    // RTC_SCL_PIN) never runs, so GPIO2 is never claimed by I2C — safe to
    // reuse for FEM_EN without any pin conflict, and without needing to
    // desolder/move the RTC's physical wiring at all: `rtcReady` simply
    // stays false (its default), and getRtcTimestamp() already has a
    // graceful built-in fallback for exactly this case (prints "NO_RTC"
    // in the SD log's timestamp column, same as if the RTC chip were
    // physically unplugged or dead) — no other code needed changing.
    // Only effect: SD log rows lose real wall-clock timestamps until this
    // is reconsidered (falls back to relative millis() timing instead) —
    // the live LoRa/dashboard telemetry is completely unaffected either
    // way, since epoch_time was already removed from the transmitted
    // packet in an earlier pass (see this file's own CLAUDE.md).
    // Re-enable by uncommenting the line below — but only once GPIO2 is
    // free again (i.e. the antenna fix moves to a different enable pin,
    // or is removed).
    // initRtc();

    // SD card — separate SPI bus, see SD_*_PIN's own comment for why these
    // specific pins. Non-fatal if missing/failed: initSdCard() itself
    // warns and leaves sdReady false, everything else keeps working.
    initSdCard();

    Serial.println("[RDY]  Sensor loop starting\n");
}


// ════════════════════════════════════════════════════════════════════
//  LOOP
// ════════════════════════════════════════════════════════════════════

void loop() {
    // These run every loop iteration — pollGps()/pollEsc() to keep their
    // UART buffers drained, checkLoraTxComplete() so an async LoRa TX
    // finishing mid-cycle (anywhere in its ~218ms SF9/BW125 airtime) is noticed
    // promptly rather than only at the next SENSOR_INTERVAL_MS tick.
    pollGps();
    pollEsc();
    checkLoraTxComplete();

    uint32_t now = millis();
    if (now - lastSensorMs < SENSOR_INTERVAL_MS) return;
    lastSensorMs = now;

    updateSensors();
    logToSD();   // every SENSOR_INTERVAL_MS tick (5Hz) — independent of the LoRa/ESP-NOW radios below, see the SD CARD LOGGING section's own comment

    // ── LoRa TX — every LORA_TX_INTERVAL_MS (250ms, SF9/BW125 airtime + margin) ──
    if (now - lastLoraTxMs >= LORA_TX_INTERVAL_MS) {
        lastLoraTxMs = now;
        loRaTx();
    }

    // ── ESP-NOW TX — every ESPNOW_TX_INTERVAL_MS (250ms/4Hz, was 200ms/5Hz) ──
    if (now - lastEspNowMs >= ESPNOW_TX_INTERVAL_MS) {
        lastEspNowMs = now;
        espNowSend();
    }

    // ── Debug dump to USB serial ─────────────────────────────────────
    Serial.println("──────────────────────────────────────────");

    // Timestamp — from the RTC, "NO_RTC" if it was never detected
    char dbgTs[24];
    getRtcTimestamp(dbgTs, sizeof(dbgTs));
    Serial.printf("  Timestamp : %s UTC  (local RTC — not transmitted, see config.h)\n", dbgTs);

    // Power
    uint16_t dbgBattVoltRaw, dbgMotorVoltRaw, dbgCurrentRaw;
    pktUnpackVoltCur(pkt.volt_cur_pack, &dbgBattVoltRaw, &dbgMotorVoltRaw, &dbgCurrentRaw);
    Serial.printf("  Motor Volt: %.2f V\n",  dbgMotorVoltRaw / PKT_SCALE_VOLT);
    Serial.printf("  Batt Volt : %.2f V\n",  dbgBattVoltRaw / PKT_SCALE_VOLT);
    Serial.printf("  Current   : %.2f A\n",  dbgCurrentRaw / PKT_SCALE_CURRENT);

    // RPM — raw edge counts + live pin state included for wiring diagnosis.
    // Edges always 0 with the pin state never changing = wiring/power issue,
    // not a code issue.
    Serial.printf("  Motor RPM : %u  (raw edges=%lu/%.1fs, pin=%d)\n",
                  pkt.motor_rpm, (unsigned long)lastMotorEdges,
                  RPM_CALC_INTERVAL_MS / 1000.0f, digitalRead(MOTOR_RPM_PIN));
    Serial.printf("  Wheel RPM : %.1f  (raw edges=%lu/%.1fs, pin=%d)\n",
                  pkt.wheel_rpm_x10 / PKT_SCALE_WHEEL_RPM, (unsigned long)lastWheelEdges,
                  RPM_CALC_INTERVAL_MS / 1000.0f, digitalRead(WHEEL_RPM_PIN));

    // Temperature
    if (pkt.temp_f == PKT_TEMP_NO_READING) {
        Serial.println("  Temp      : DISCONNECTED (check pull-up + data line wiring)");
    } else {
        Serial.printf("  Temp      : %d °F  (%.2f °C raw)\n", pkt.temp_f, lastTempRawC);
    }

    // GPS
    Serial.printf("  GPS valid : %s\n",      (pkt.flags & PKT_FLAG_GPS_VALID) ? "YES" : "NO");
    Serial.printf("  Satellites: %u\n",       pktGetSatellites(pkt.sat_esc_state));
    Serial.printf("  Speed     : %.1f mph\n", pkt.speed_mph_x10 / PKT_SCALE_SPEED);
    Serial.printf("  Latitude  : %.6f\n",     pkt.latitude);
    Serial.printf("  Longitude : %.6f\n",     pkt.longitude);
    Serial.printf("  HDOP      : %.1f\n",     (pkt.hdop_x10 == PKT_HDOP_NO_FIX) ? 99.9f : (pkt.hdop_x10 / 10.0f));

    // IMU
    Serial.printf("  IMU valid : %s\n",      (pkt.flags & PKT_FLAG_IMU_VALID) ? "YES" : "NO");
    Serial.printf("  Pitch     : %d °\n",     pkt.pitch_deg);
    Serial.printf("  Accel     : %.3f g\n",   pkt.accel_g_x1000 / PKT_SCALE_G);
    Serial.printf("  Lateral   : %.3f g\n",   pkt.lateral_g_x1000 / PKT_SCALE_G);
    Serial.printf("  Vertical  : %.3f g\n",   pkt.vertical_g_x1000 / PKT_SCALE_G);

    // ESC
    if (pkt.flags & PKT_FLAG_ESC_VALID) {
        Serial.printf("  ESC Mode  : %s  (code=%u)\n",  esc.mode,  pktGetEscMode(pkt.flags));
        Serial.printf("  ESC State : %s  (code=%u)\n",  esc.state, pktGetEscState(pkt.sat_esc_state));
        Serial.printf("  Setpoint  : %u %%\n", pkt.esc_setpoint_pct);
        Serial.printf("  Live      : %u %%\n", pkt.esc_live_pct);
        Serial.printf("  Ramp      : %u %%\n", pkt.esc_ramp_pct);
    } else {
        Serial.println("  ESC       : waiting for data...");
    }

    Serial.println("──────────────────────────────────────────\n");
}
