SiDaMan1/Greenpower-Telemetry-REPO/steering_wheel_display/display_receiver/BigShoulders_18pt_SemiBold12pt7b.h

const uint8_t BigShoulders_18pt_SemiBold12pt7bBitmaps[] PROGMEM = {
  0x00, 0xEE, 0xEE, 0xEE, 0xEE, 0xEE, 0xE6, 0x66, 0x00, 0xFF, 0xF0, 0xCF,
  0x9F, 0x3E, 0x7C, 0xD8, 0x80, 0x07, 0x18, 0x1C, 0xE0, 0x73, 0x81, 0x8E,
  0x0E, 0x30, 0xFF, 0xF3, 0xFF, 0xDF, 0xFF, 0x1C, 0x60, 0x73, 0x81, 0xCE,
  0x06, 0x38, 0xFF, 0xFB, 0xFF, 0xC3, 0x9C, 0x0C, 0x70, 0x71, 0x81, 0xCE,
  0x07, 0x38, 0x00, 0x1C, 0x0E, 0x0F, 0x9F, 0xEE, 0x77, 0x1F, 0x8F, 0xC7,
  0xE3, 0xF0, 0x3E, 0x0F, 0xE3, 0xF0, 0x3F, 0x8F, 0xC7, 0xE3, 0xF1, 0xF8,
  0xFF, 0xE7, 0xE0, 0xE0, 0x70, 0x70, 0x37, 0xC1, 0xB7, 0x19, 0x98, 0xCC,
  0xCC, 0x66, 0x43, 0x76, 0x1F, 0x60, 0x73, 0x00, 0x30, 0x01, 0x98, 0x1B,
  0xE0, 0xD9, 0x8C, 0xCC, 0x66, 0x66, 0x33, 0x31, 0x9B, 0x0F, 0xB8, 0x3C,
  0x3E, 0x07, 0xF0, 0x63, 0x06, 0x30, 0x63, 0x07, 0x30, 0x77, 0x03, 0xE0,
  0x3C, 0x07, 0x98, 0x7D, 0x8E, 0xF8, 0xEF, 0x8E, 0x78, 0xE3, 0x8E, 0x1C,
  0xE3, 0xE7, 0xFF, 0x7F, 0x40, 0xFF, 0xED, 0x80, 0x19, 0x8C, 0xE7, 0x33,
  0x9C, 0xE7, 0x39, 0xCE, 0x73, 0x9C, 0xE7, 0x18, 0xE7, 0x18, 0xE3, 0xE1,
  0x87, 0x0C, 0x38, 0xE3, 0x86, 0x18, 0x71, 0xC7, 0x1C, 0x71, 0xC6, 0x18,
  0xE3, 0x8E, 0x31, 0xC6, 0x38, 0x25, 0xD9, 0xF2, 0x00, 0x0C, 0x03, 0x00,
  0xC3, 0xFF, 0xFF, 0xC3, 0x00, 0xC0, 0x30, 0x0C, 0x00, 0xFF, 0xF2, 0x6C,
  0xFF, 0xFF, 0xFF, 0xFF, 0xF0, 0x07, 0x0E, 0x0E, 0x0E, 0x0E, 0x0C, 0x1C,
  0x1C, 0x1C, 0x1C, 0x18, 0x38, 0x38, 0x38, 0x30, 0x70, 0x70, 0x70, 0x70,
  0x60, 0xE0, 0xE0, 0xE0, 0xE0, 0x3E, 0x3F, 0xBC, 0xFC, 0x7E, 0x3F, 0x1F,
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
  {   651,   9,  19,  11,    1,  -18 },   // 0x47 'G'
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

const GFXfont BigShoulders_18pt_SemiBold12pt7b PROGMEM = {
  (uint8_t  *)BigShoulders_18pt_SemiBold12pt7bBitmaps,
  (GFXglyph *)BigShoulders_18pt_SemiBold12pt7bGlyphs,
  0x20, 0x7E, 28 };

// Approx. 2378 bytes
