SiDaMan1/Greenpower-Telemetry-REPO/steering_wheel_display/display_receiver/BigShoulders_18pt_SemiBold14pt7b.h

const uint8_t BigShoulders_18pt_SemiBold14pt7bBitmaps[] PROGMEM = {
  0x00, 0x77, 0x77, 0x77, 0x77, 0x77, 0x77, 0x77, 0x76, 0x60, 0x0F, 0xFF,
  0xE7, 0xE7, 0xE7, 0xE7, 0xE7, 0x67, 0x42, 0x03, 0xCF, 0x01, 0xC7, 0x00,
  0xE3, 0x80, 0x71, 0xC0, 0x79, 0xE0, 0x38, 0xE0, 0xFF, 0xFE, 0x7F, 0xFF,
  0x3F, 0xFF, 0x07, 0x1C, 0x03, 0x8E, 0x01, 0xC7, 0x01, 0xE7, 0x87, 0xFF,
  0xF3, 0xFF, 0xF9, 0xFF, 0xFC, 0x3C, 0x70, 0x1C, 0x78, 0x0E, 0x38, 0x07,
  0x1C, 0x07, 0x8E, 0x03, 0x8F, 0x00, 0x0E, 0x03, 0x80, 0xE0, 0xFC, 0x7F,
  0xFE, 0xFE, 0x1F, 0x87, 0xE1, 0xF8, 0x7E, 0x1F, 0xC0, 0xF8, 0x1F, 0xC3,
  0xF8, 0x1F, 0x01, 0xF8, 0x7E, 0x1F, 0x87, 0xE1, 0xF8, 0x7F, 0x3D, 0xFF,
  0x3F, 0x83, 0x80, 0xE0, 0x38, 0x78, 0x0D, 0xF8, 0x3B, 0x38, 0x66, 0x71,
  0xCC, 0xE3, 0x19, 0xCE, 0x33, 0x98, 0x67, 0x70, 0xFC, 0xC0, 0xFB, 0x00,
  0x06, 0x00, 0x18, 0x00, 0x33, 0xC0, 0xCF, 0xC1, 0xB9, 0x86, 0x73, 0x0C,
  0xE6, 0x31, 0xCC, 0xE3, 0x99, 0x87, 0x37, 0x07, 0xEC, 0x0F, 0x80, 0x1F,
  0x00, 0xFE, 0x07, 0x1C, 0x1C, 0x70, 0x71, 0xC1, 0xC7, 0x07, 0x1C, 0x0E,
  0xE0, 0x3F, 0x00, 0xFC, 0x03, 0xE0, 0x1F, 0xB8, 0x7E, 0xE3, 0xDF, 0x8E,
  0x7E, 0x38, 0xF8, 0xE1, 0xE3, 0x87, 0x8F, 0x0F, 0x1E, 0x7E, 0x7F, 0xFC,
  0xFE, 0x40, 0xFF, 0xFE, 0xD8, 0x1C, 0x63, 0x8E, 0x71, 0xC7, 0x3C, 0xF3,
  0x8E, 0x38, 0xE3, 0x8E, 0x38, 0xE3, 0x8E, 0x3C, 0x71, 0xC7, 0x0E, 0x38,
  0xE1, 0xC0, 0xE0, 0xE1, 0xC1, 0xC3, 0x87, 0x87, 0x0E, 0x1C, 0x38, 0x78,
  0xF1, 0xE3, 0xC7, 0x8F, 0x1E, 0x38, 0x70, 0xE1, 0xC7, 0x8E, 0x1C, 0x38,
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
  {   887,  11,  22,  13,    1,  -21 },   // 0x47 'G'
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

const GFXfont BigShoulders_18pt_SemiBold14pt7b PROGMEM = {
  (uint8_t  *)BigShoulders_18pt_SemiBold14pt7bBitmaps,
  (GFXglyph *)BigShoulders_18pt_SemiBold14pt7bGlyphs,
  0x20, 0x7E, 33 };

// Approx. 2996 bytes
