SiDaMan1/Greenpower-Telemetry-REPO/steering_wheel_display/display_receiver/BigShoulders_18pt_SemiBold9pt7b.h

const uint8_t BigShoulders_18pt_SemiBold9pt7bBitmaps[] PROGMEM = {
  0x00, 0xFF, 0xFF, 0xFC, 0xF0, 0xDE, 0xE7, 0x30, 0x0C, 0xC3, 0x30, 0x66,
  0x0C, 0xD7, 0xFC, 0x66, 0x0C, 0xC1, 0x98, 0xFF, 0x9F, 0xF1, 0x98, 0x33,
  0x06, 0x61, 0xD8, 0x00, 0x30, 0xCF, 0xBB, 0xCF, 0x3C, 0xF0, 0xF9, 0xF0,
  0xF3, 0xCF, 0x3F, 0xDE, 0x30, 0xC0, 0xE1, 0xD8, 0xAC, 0xD6, 0x4B, 0x67,
  0xA0, 0x20, 0x30, 0x17, 0x9B, 0x49, 0x2C, 0x94, 0x6E, 0x3C, 0x78, 0xCC,
  0xCC, 0xCC, 0x6C, 0x78, 0x70, 0xF6, 0xDE, 0xDE, 0xCE, 0xC6, 0xFF, 0x7D,
  0xFE, 0x36, 0x6C, 0xCC, 0xCC, 0xCC, 0xCC, 0xCC, 0xC6, 0x63, 0xC6, 0x63,
  0x33, 0x33, 0x33, 0x33, 0x33, 0x66, 0x4C, 0xB7, 0xF2, 0x10, 0x20, 0x47,
  0xF1, 0x02, 0x04, 0x00, 0xFD, 0x60, 0xFC, 0xF0, 0x18, 0xC6, 0x33, 0x18,
  0xC6, 0x73, 0x18, 0xC6, 0x63, 0x18, 0xC6, 0x00, 0x7D, 0xDB, 0x36, 0x6C,
  0xD9, 0xF3, 0xE7, 0xCF, 0x9B, 0x36, 0x6F, 0xCF, 0x00, 0xFD, 0xB6, 0xDB,
  0x6D, 0xB6, 0xC0, 0xFF, 0x3C, 0xF3, 0xCC, 0x31, 0xDE, 0x73, 0x0C, 0x30,
  0xFF, 0xF0, 0xFF, 0xF1, 0xC6, 0x31, 0xC7, 0xDF, 0x0F, 0x3C, 0xF3, 0xFD,
  0xE0, 0x1C, 0x1C, 0x14, 0x34, 0x34, 0x64, 0x64, 0x6C, 0xFF, 0xFF, 0x0C,
  0x0C, 0x0C, 0x0C, 0xFD, 0xFB, 0x06, 0x0C, 0x1B, 0xBF, 0x67, 0x07, 0x8F,
  0x1E, 0x7F, 0xCF, 0x80, 0x7D, 0xDB, 0x36, 0x6C, 0x1B, 0x3F, 0x67, 0xCF,
  0x9F, 0x3E, 0x6F, 0xCF, 0x80, 0xFF, 0xFC, 0x18, 0x70, 0xC1, 0x87, 0x0C,
  0x18, 0x30, 0xC1, 0x83, 0x0C, 0x00, 0x7F, 0xBC, 0xF3, 0xCF, 0x37, 0xBF,
  0xCF, 0x3C, 0xF3, 0xFD, 0xF0, 0xFF, 0xBC, 0xF3, 0xCF, 0x3C, 0xFF, 0x6C,
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
  {   358,   7,  14,   8,    1,  -13 },   // 0x47 'G'
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

const GFXfont BigShoulders_18pt_SemiBold9pt7b PROGMEM = {
  (uint8_t  *)BigShoulders_18pt_SemiBold9pt7bBitmaps,
  (GFXglyph *)BigShoulders_18pt_SemiBold9pt7bGlyphs,
  0x20, 0x7E, 21 };

// Approx. 1633 bytes
