SiDaMan1/Greenpower-Telemetry-REPO/(commit log)

2026-05-01 attempting to fix ui
    [display_receiver.ino]
2026-05-06 reworked display
    this is the most recent verison
    [dash_data.h, display_receiver.ino]
2026-05-07 Add greenpower_sender sketch
    Heltec ESP32-S3 LoRa V4 sender for the Greenpower data collection system.
    Reads GPS (NMEA/Serial1), MPU-6050 IMU (I2C), DS18B20 temperature (1-Wire),
    24V battery voltage (ADC divider), HSTS016L 100A current (ADS1115 I2C),
    and ESC telemetry (UART Serial2 GPIO 45/46). LoRa TX stub ready for next step.
2026-05-08 added the sender code and fixed other stuff
    [config.h, greenpower_sender.ino, throttle_controller.ino]
2026-08-20 Fix Chart.js canvas growth/sizing bugs, redesign Overview page
    - Fix charts expanding constantly: canvas was a direct flex item, and
    Chart.js's responsive resize (setting new width/height attributes each
    redraw) fed back into the flex layout, growing forever. Every canvas now
    sits in a position:relative .chart-canvas-wrap with the canvas itself
    position:absolute, removing it from flow entirely.
    - Fix charts on non-default tabs loading at 0x0: Chart.js's ResizeObserver
    doesn't reliably catch a container going display:none -> visible. Tabs
    now explicitly call .resize() on every chart when opened.
    - Add .claude/launch.json for local dev server testing via the preview tool.
    - Redesig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
2026-08-22 meybe railway fix
2026-08-22 Fix mobile toolbar gradients, symmetric backdrop fades, exit toast, test mode
    - Gradient fills switched from 135deg to "to right" across the toggle,
    onboarding button, and mobile nav active-tab highlights - a diagonal
    gradient barely showed both colors on wide-but-short (and even a
    near-square) elements, reading as solid blue instead of an actual blend.
    - Every full-screen mobile dimming backdrop (nav sheet, confirm modals,
    update banner) now fades in AND out symmetrically instead of only
    fading out at the bottom.
    - Replaced the unreliable "Close App" confirmation modal with a genuine
    "press back again to exit" toast - relies on a real second back press
    (which Android handles n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
2026-08-22 Fix toggle gradient being hidden behind its own thumb
    The "to right" direction fix was correct, but the opaque thumb covers
    most of the track when checked, leaving only a ~5px sliver exposed on
    one side - too thin to show real color with an evenly-spread 2-stop
    gradient. Switched to explicit color stops that hold each color solid
    through its own exposed strip and compress the blend into the band the
    thumb actually covers, so both visible edges now show clear, distinct
    color instead of cutting off. Verified with a real screenshot.
2026-08-22 Align toggle gradient stops exactly to the thumb's real edges
    The previous fix (0/40/92/100 stops) was only approximately inside the
    thumb's footprint, leaving a ~1px still-blended band right next to the
    thumb on each side - visible as a thin off-color seam. Recomputed the
    thumb's exact pixel span (23px-45px of the 50px track = 46%-90%) and
    set the solid-color boundaries to match precisely, so every visible
    pixel outside the thumb is provably pure accent/accent2 with zero
    blended pixels ever exposed.
2026-08-22 Revert toggle to a plain smooth gradient across the whole track
    The hard-edge rework misread the ask - the goal was a smooth blend
    visible across the entire toggle background (thumb included), not a
    seam-free hard split. Back to a plain unweighted 2-stop
    linear-gradient(to right, var(--accent), var(--accent2)) spanning the
    full width.
2026-08-22 Hold a few px of solid color at each end of the toggle gradient
    The plain 2-stop gradient started blending immediately at both edges,
    so neither end read as a clean solid color. Added 8%/92% stops
    (~4px on a 50px track) to hold pure accent/accent2 briefly before the
    blend starts, keeping the smooth transition in the middle.
2026-08-22 Widen the solid color margins on the toggle gradient further
    Bumped the solid-color stops from 8%/92% to 20%/80% (~10px each side
    on the 50px track), same technique, just a wider solid margin and a
    narrower blend band in the middle.
2026-08-22 Stretch the toggle gradient background past the switch's own edges
    Previous fix widened solid-color stops inside the track's fixed 50x30
    box, which still clipped the gradient to the switch's own edges.
    Moved the gradient onto a ::before pseudo-element 10px wider than the
    track on each side, sitting behind it, so the color genuinely bleeds
    past the switch while the switch itself stays the same size. Track
    background goes transparent when checked so the pseudo shows through;
    left z-index off the pseudo since a negative z-index there would let
    it interact with the row's own stacking context instead of just
    sitting behind the thumb.
2026-08-22 Shrink toggle gradient bleed to 5px and isolate it behind the track
    Reduced the pseudo-element's overhang from 10px to 5px each side.
    Also gave the track isolation:isolate so it owns its own stacking
    context, and put z-index:-1 back on the pseudo now that it's safely
    contained inside that context - keeps the gradient explicitly behind
    the track/thumb without risking it leaking behind the row's own card
    background the way a bare z-index:-1 would in the parent's context.
2026-08-22 Shrink toggle gradient bleed to zero - flush with the switch edges
    5px minus another 5px is 0: the pseudo-element's left/right went from
    -5px to flush 0, so the gradient layer is now exactly the same size
    as the track, even on both sides. Kept it as a separate ::before
    layer behind the track (rather than collapsing back to a plain
    background on the track) so the isolation/z-index stacking safety
    stays in place if bleed comes back later.
2026-08-24 throttle controller stuff
2026-08-26 added pcb folder
    [Data collection pcb.kicad_pcb, Data collection pcb.kicad_sch]
2026-08-27 finished schematic need to assign footprints
    [Data collection pcb.kicad_sch]
2026-08-27 finished layout
    [Data collection pcb.kicad_pcb, Data collection pcb.kicad_sch]
2026-08-28 finished data collection pcb
    [Data collection pcb-B_Cu.gbr, Data collection pcb-B_Mask.gbr, Data collection pcb-B_Silkscreen.gbr, Data collection pcb-Edge_Cuts.gbr, Data collection pcb-F_Cu.gbr, Data collection pcb-F_Mask.gbr, Data collection pcb-F_Silkscreen.gbr, Data collection pcb-NPTH.drl]
2026-09-04 pcb something
2026-09-04 added sd and rtc to pcb
    [Data collection pcb.kicad_pcb, Data collection pcb.kicad_sch]
